bakul14/siemens_kur/second_attempt/strangled.jpg

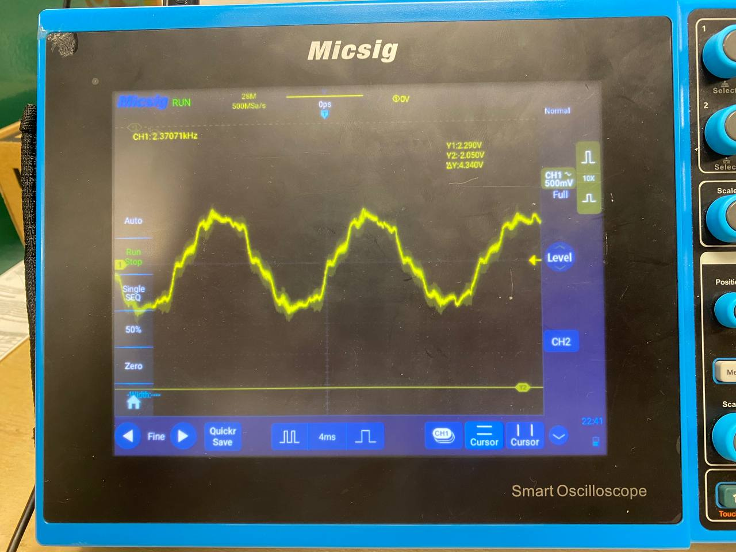
second_attempt/strangled.jpg
