bakul14/siemens_kur/second_attempt/figner_only.jpg

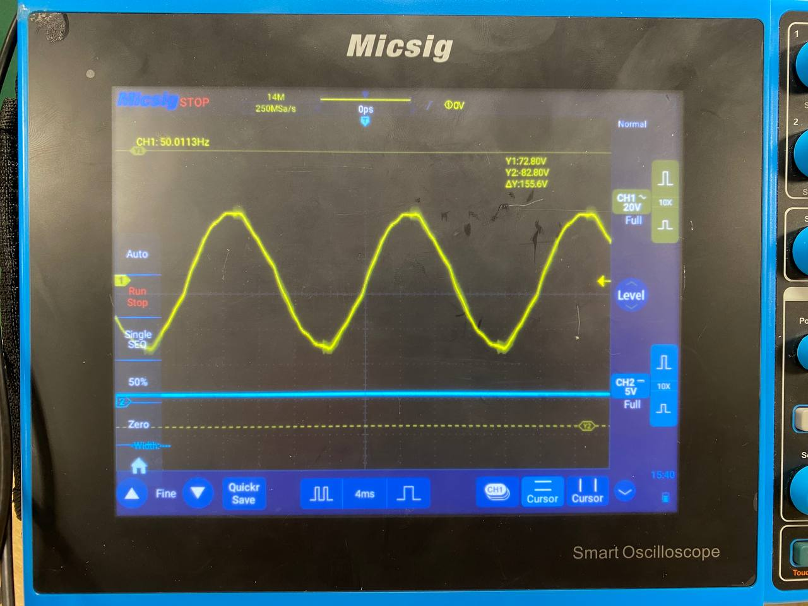
second_attempt/figner_only.jpg
