bakul14/siemens_kur/PDFs/ПЭ_Бакулевский.pdf

Поз.
обозначение

### Наименование

Кол.
Примеч.

Диоды

VD2, VD3 | 15SQ045 (Dongguan YFW, Китай) | 2
VD1 | 1N4002 (Diotec Semiconductor, Германия) | 1

Конденсаторы

С4 | К10-17Б 1000пФ 50В ±5% (Murata Electronics, Япония) | 1
С1 | К10-17Б 220пФ 50В ±5% (Murata Electronics, Япония) | 1
С7 | К73-17 0,68мкФ 250В ±5% | 1

(Кузнецкий завод конденсаторов, Россия)

С6, С8 | К50-35 2200мкФ 35В ±20% (JB Capacitors, Гонконг) | 2
С2, С5 | К50-35 мини 47мкФ 50В ±20% (JB Capacitors, Гонконг) | 2
С3 | К50-35 100мкФ 63В ±20% (JB Capacitors, Гонконг)

Разъёмы

XS1 | Гнездо стерео 3,5мм ST-025 | 1
| (Dragon City Industries, Китай)
XP1 | Клеммник разъёмный 15EDGRC-3.81-03P (Degson, Китай) | 1
XP2 | Клеммник разъёмный 15EDGRC-3.81-02P (Degson, Китай) | 1

Резисторы

R14, R15 | CF-25 0,25Вт 4.7кОм ±5% | 2
R3, R5 | CF-25 0,25Вт 680Ом ±5% | 2
R12, R13 | CF-25 0,25Вт 3кОм ±5% | 2
R11 | CF-25 0,25Вт 15кОм ±5% | 1

# ИУ4.11.03.03.23.05.52.04.001 ПЭ3

Изм | Лист | № докум. | Подп. | Дата
Разраб. | Бакулевский

## Усилитель низкой частоты

Перечень элементов

Лит. | Лист | Листов
Пров. | Семенцов С. Г. | 1 | 2
МГТУ им Н.Э. Баумана
Кафедра ИУ4
Группа ИУ4 – 52Б

Н. контр.
Утв.

Поз. обозначение | Наименование | | Примеч.
R7 | CF-25 0,25Вт 1,2кОм ±5% | 1
R14 | CF-25 0,25Вт 2кОм ±5% | 1
R18 | CF-100 1Вт 10Ом ±5% | 1
R4 | CF-100 1Вт 15кОм ±5% | 2
R6, R17 | SQP 5Вт 0,1Ом ±5% | 2
RP1 | 3296W-1-1-2LF 0,25Вт 1кОм ±20% (Bourns, США) | 1

Кол.

Транзисторы

VT3, VT4, VT6 | BC546B (Diotec Semiconductor, Германия) | 3
VT1, VT2, VT5 | BC556B (Diotec Semiconductor, Германия) | 3
VT7 | IRF540NPBF (Infineon Technologies, Германия) | 1
VT8 | IRF9540NPBF (Infineon Technologies, Германия) | 1

# ИУ4.11.03.03.23.05.52.04.001 ПЭ 3

Лист

2
Изм | Лист | № докум. | Подп. | Дата
