bakul14/siemens_kur/PDFs/ПД2_Бакулевский.pdf

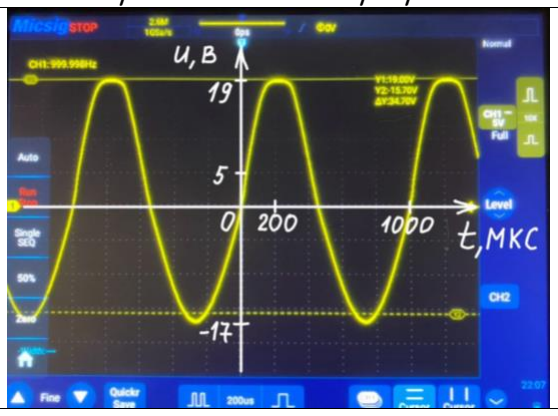
[picture p22: figure]

Максимальная мощность

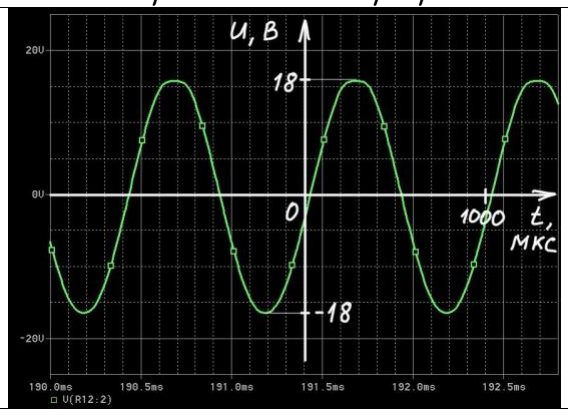
[picture p23: figure]

Теоретический график | Практический график | Вывод
| | Амплитуда входного сигнала: 80мВ; Амплитуда теоретического сигнала: 18В; Амплитуда измеренного сигнала: 19В у верхней полуволны и 17В у нижней полуволны; Сопротивление нагрузки: 3Ом; Частота: 1кГц; 2 (18×0,71) = 54Вт; Мощность: 3 Максимальная мощность усилителя совпадает с расчетной.

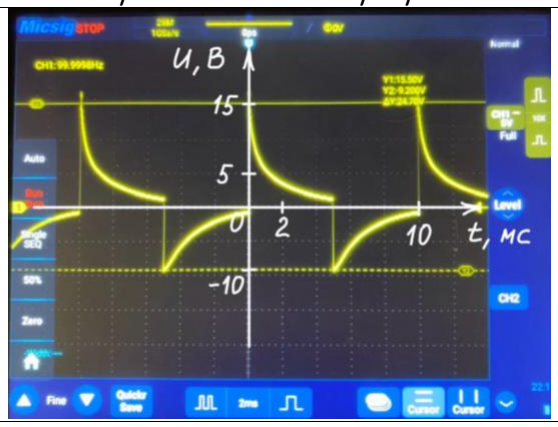
[picture p24: figure]

Переходная характеристика: 100 Гц

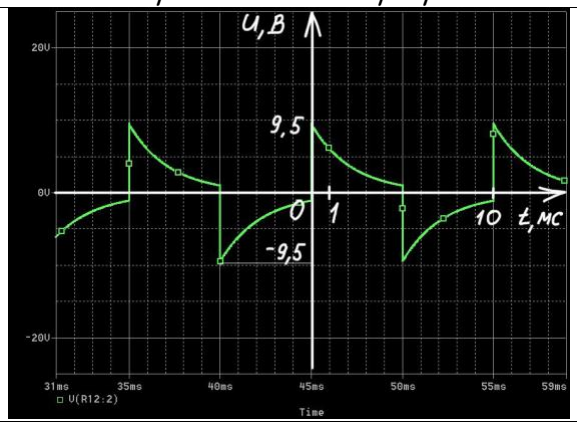
[picture p25: figure]

Теоретический график | Практический график | Вывод
| | Амплитуда входного сигнала: 25мВ; Амплитуда измеренного выходного сигнала выше расчетного;

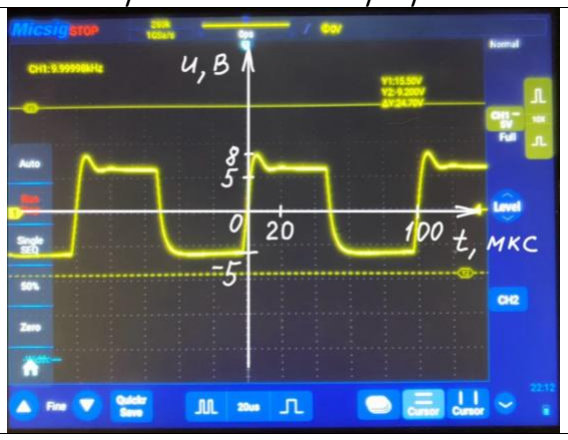
[picture p26: figure]

Переходная характеристика: 10 кГц

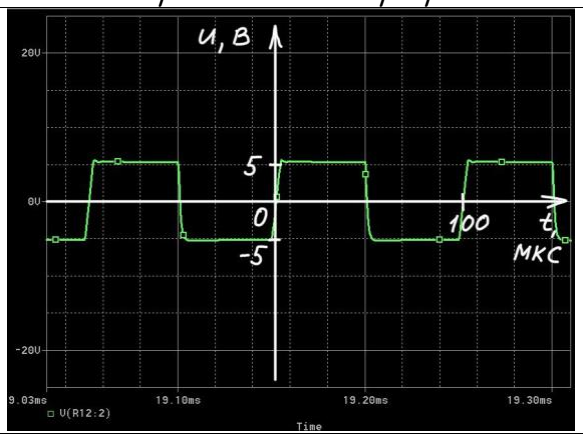
[picture p27: figure]

Теоретический график | Практический график | Вывод
| | Амплитуда входного сигнала: 25мВ; Амплитуда измеренного выходного сигнала совпадает с расчетной; Выброс на фронте измеренного сигнала выше расчетного.

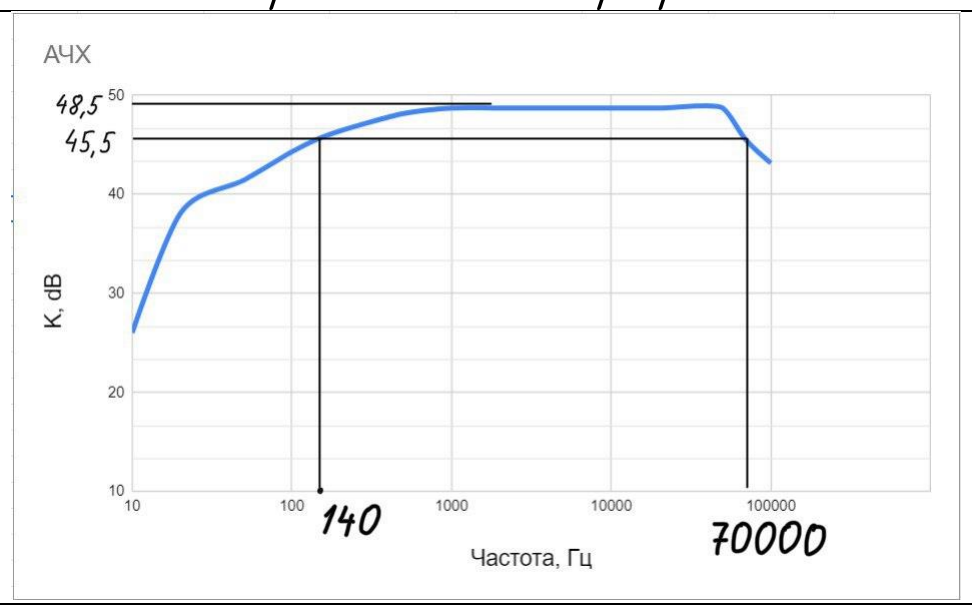
[picture p28: figure]

Амплитудо-частотная характеристика

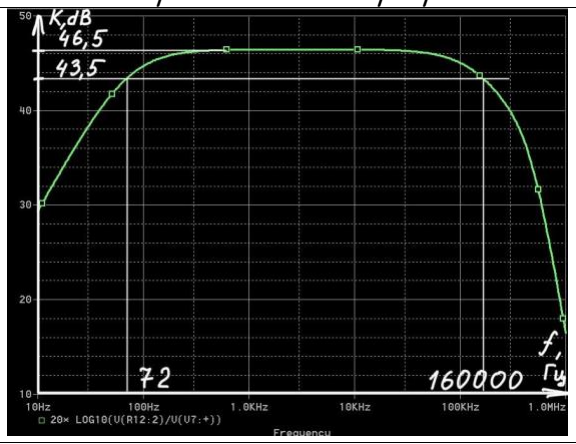
[picture p29: figure]

Теоретический график | Практический график | Вывод
| | Амплитуда входного сигнала: 25мВ; Расчетная полоса пропускания: 72Гц…160кГц; Измеренная полоса пропускания: 140Гц…70кГц.
