bakul14/siemens_kur/second_attempt/new_finger.jpg

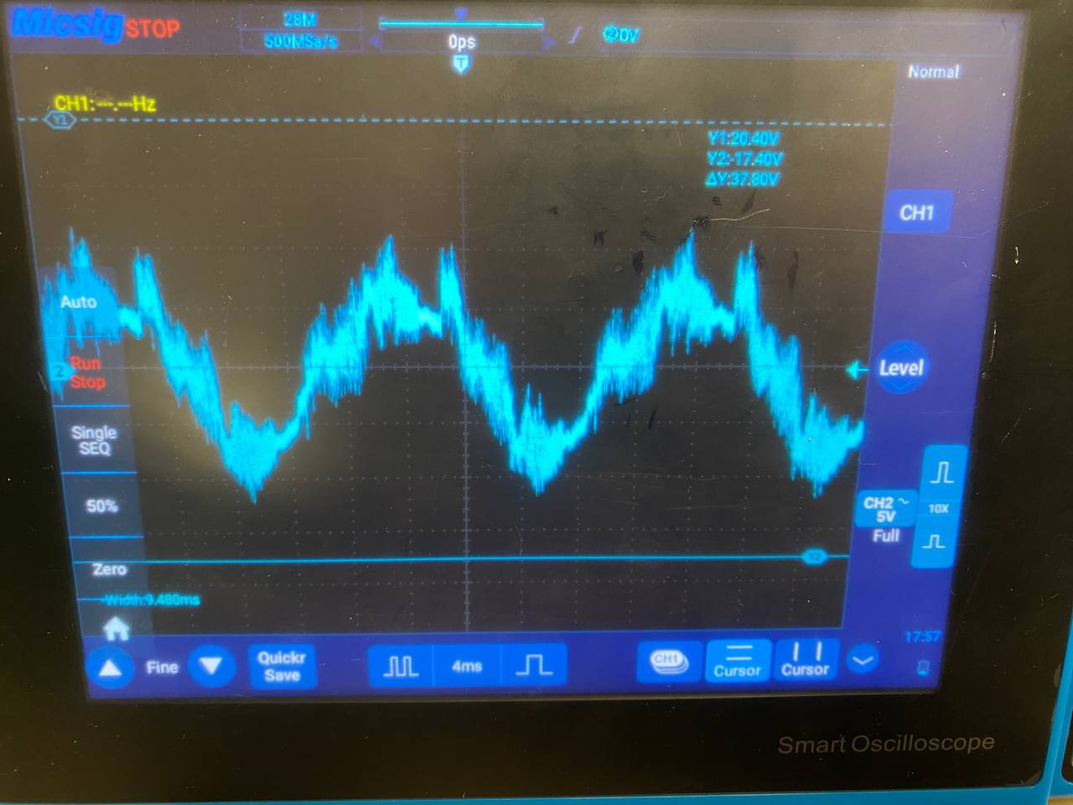
second_attempt/new_finger.jpg
