bakul14/siemens_kur/second_attempt/scheme.png

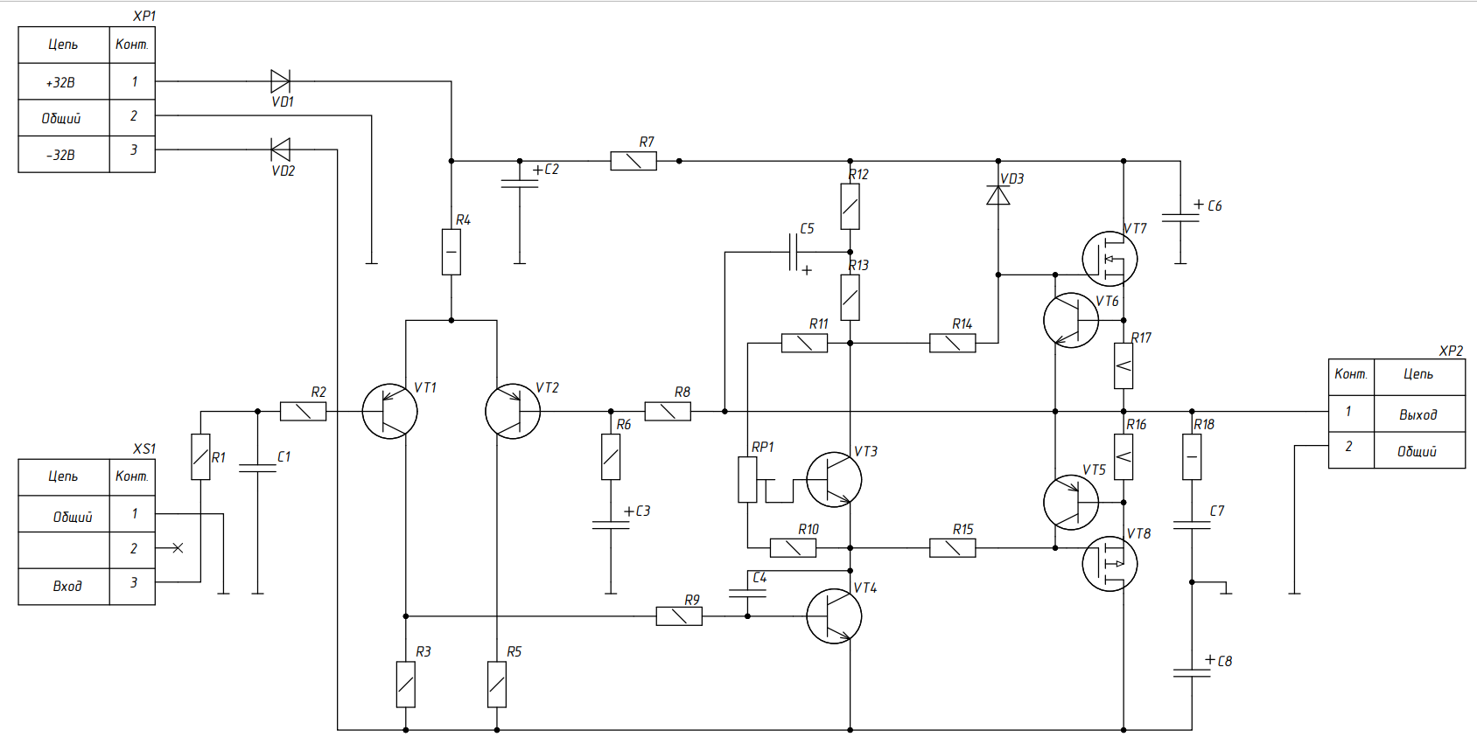
second_attempt/scheme.png
