bakul14/siemens_kur/second_attempt/strangled_with_finger.jpg

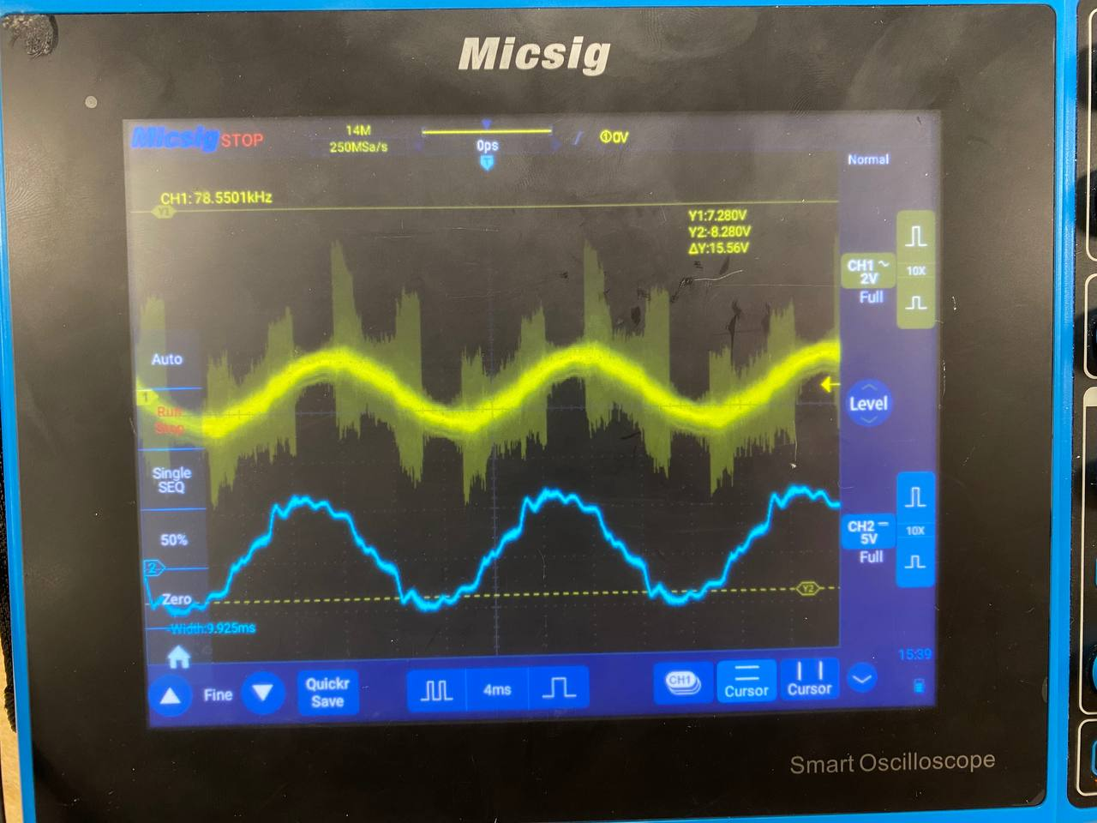
second_attempt/strangled_with_finger.jpg
