bakul14/siemens_kur/src/word/1khz.png

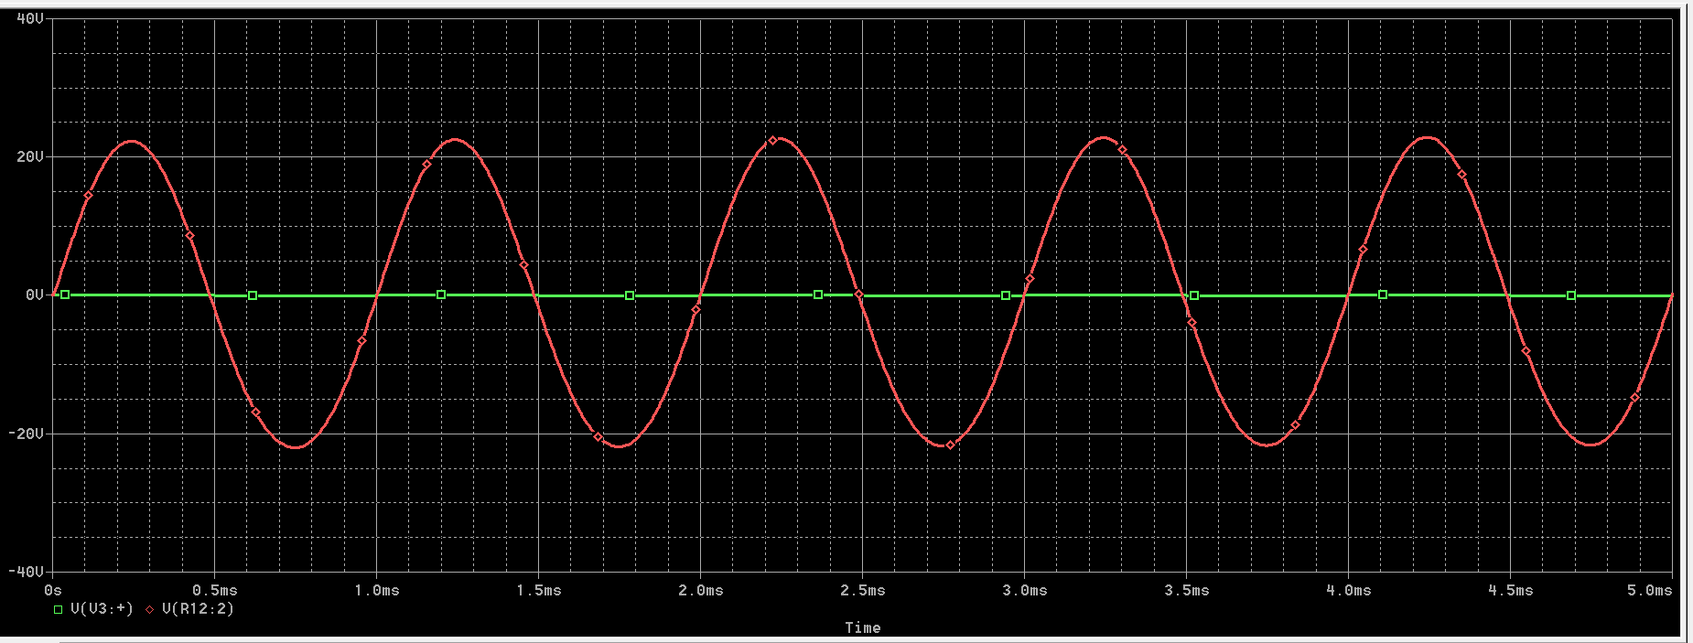
src/word/1khz.png
