bakul14/siemens_kur/src/word/20k.png

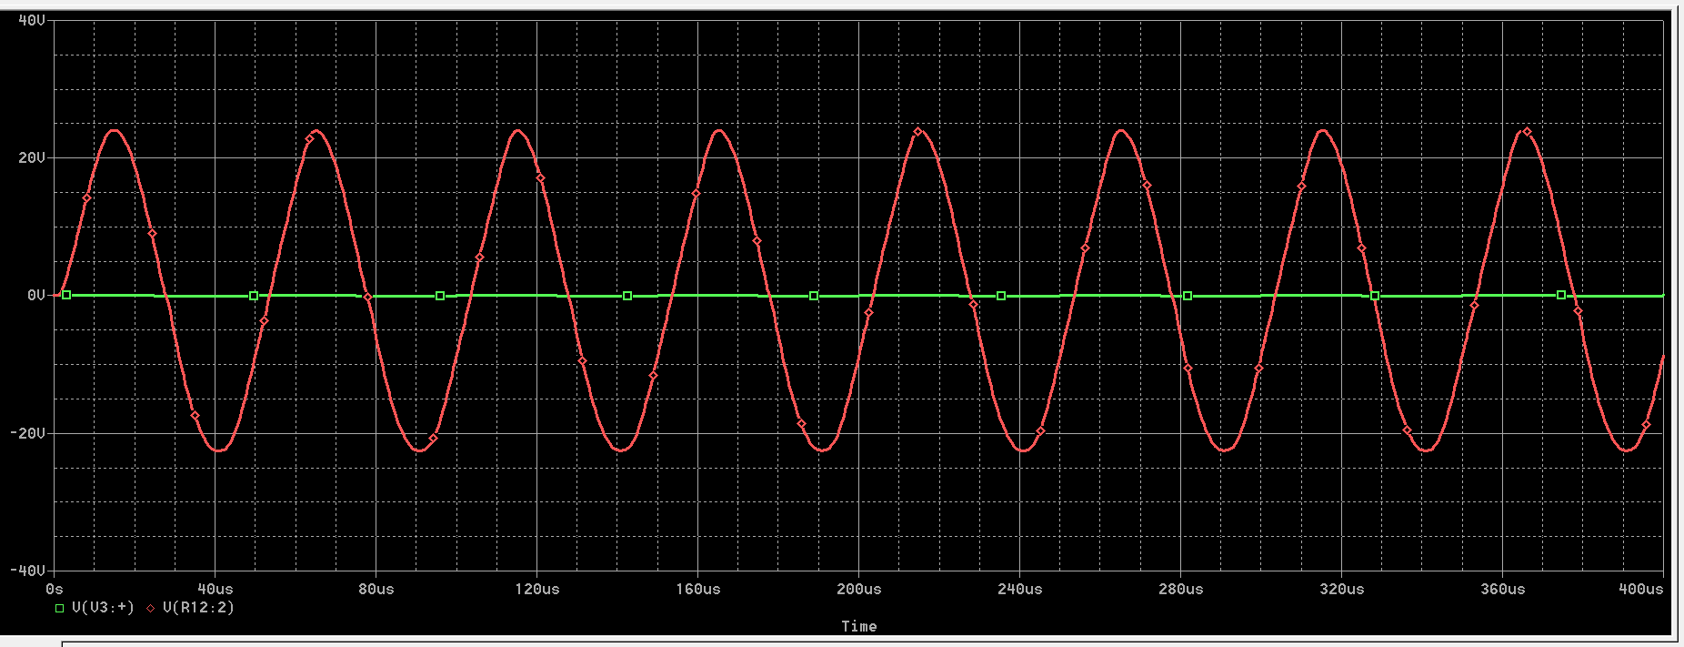
src/word/20k.png
