bakul14/siemens_kur/src/word/max_power.jpg

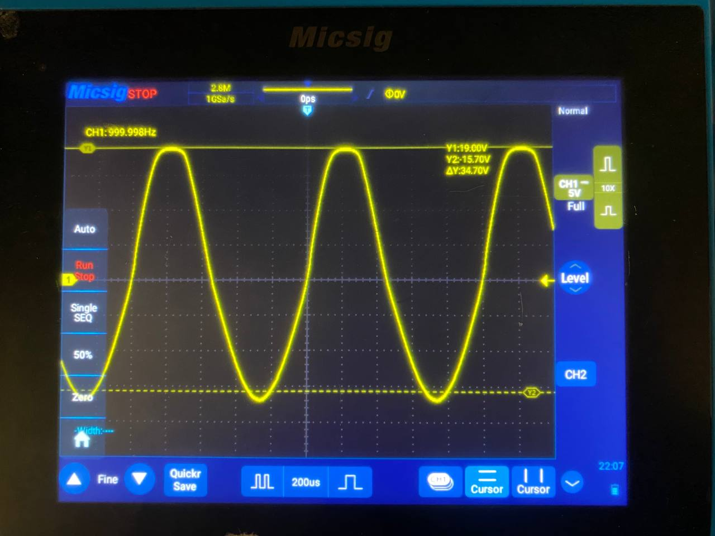
src/word/max_power.jpg
