bakul14/siemens_kur/src/word/pulse.png

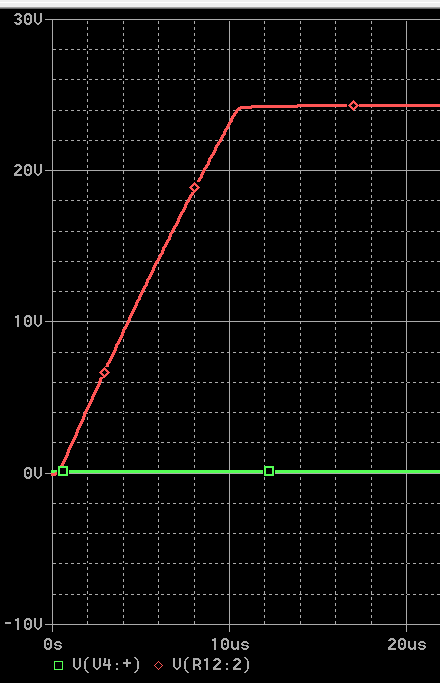
src/word/pulse.png
