bakul14/siemens_kur/src/word/pulse_wide.png

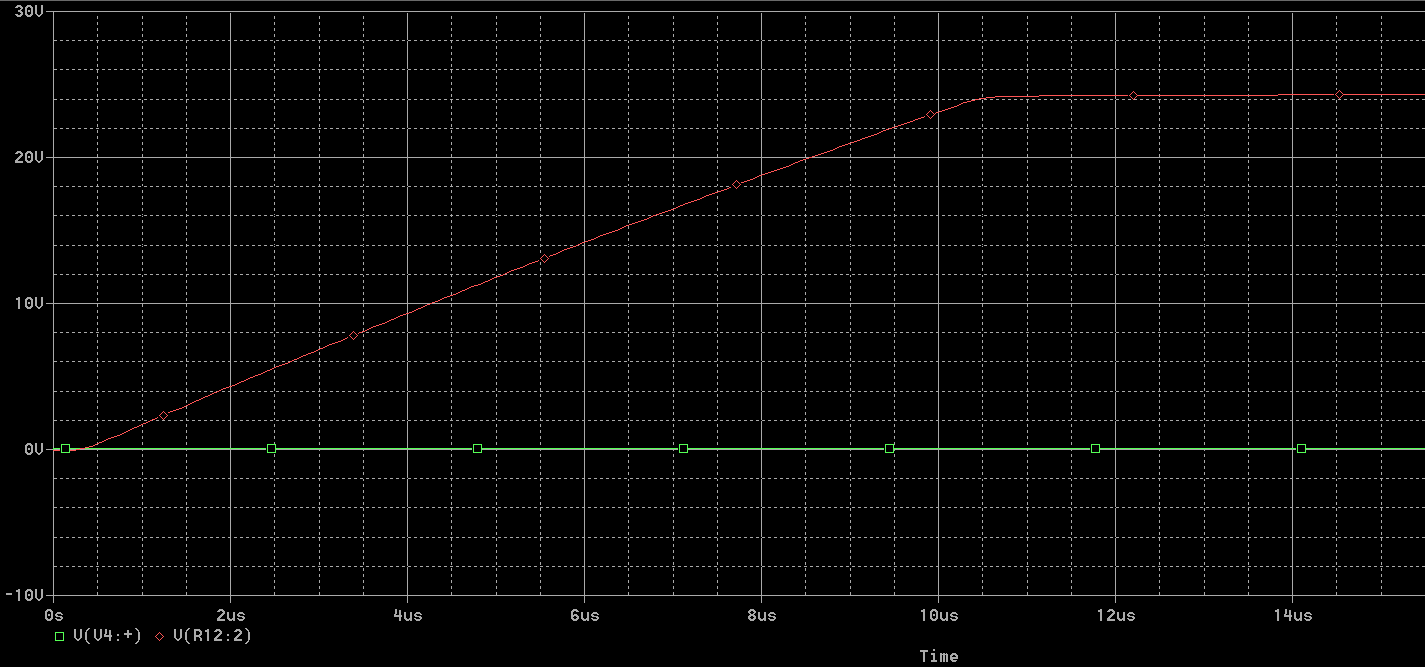
src/word/pulse_wide.png
