bakul14/siemens_kur/src/altium/amplifier60w/PCB1.step

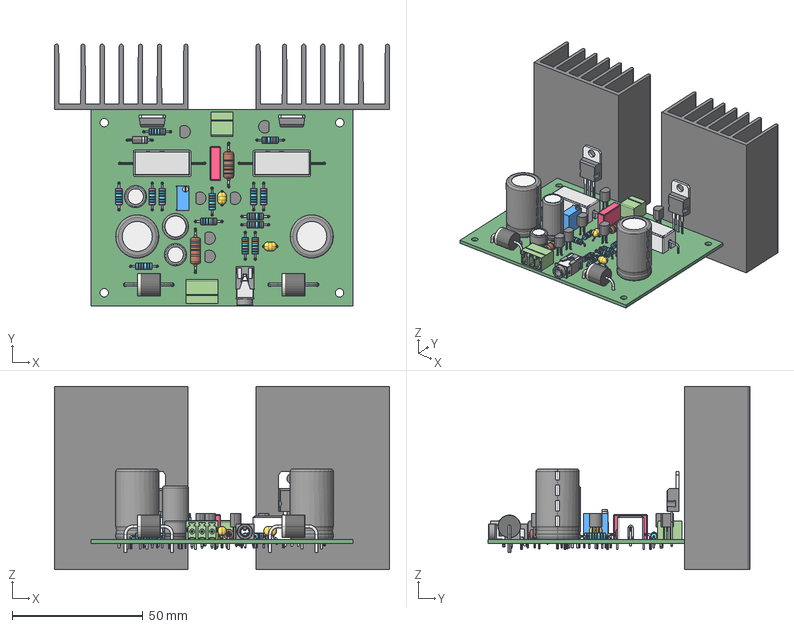
[picture p50: CAD file, 2023-12-01]
src/altium/amplifier60w/PCB1.step
128.0 x 100.0 x 70.0 mm
15EDGRC-3.81-03P-14-00A(H)_RGB5220458
15EDGRC-3.81-02P-14-00A(H)_RGB5220458
Telo_konektora
Kontakt_most
Kontakt_1
Kontakt_2
User_Library-TO-220-4_Case_TO-220_____________ x 2
User_Library-TO-220-4_Rad_Case_TO-220_____________ x 2
User_Library-TO-92B x 6
R6,_axial x 2
DO_41_375mil001
DO_41_375mil
DO_41_375mil003
RESAR3250W80L2200T1000H900_5W x 2
TRIM_BOURNS_3296Y
CAPR1000-400X1300X950
CAPRR508-350X500X500 x 2
CAPPR500-1000X2050
CAPPR350-800X700 x 2
radiator_RGB4408131 x 2
