bakul14/siemens_kur/(list of files, cad)

Other CAD files:
src/inventor/assembling2.dwg
src/inventor/assembling.dwg
src/inventor/e1.dwg
src/altium/amplifier60w/Sheet1.dwg
src/inventor/OldVersions/assembling2.0018.dwg
src/inventor/OldVersions/assembling2.dwg
src/inventor/OldVersions/assembling.0017.dwg
src/inventor/OldVersions/e1.0007.dwg
src/altium/amplifier60w/PCB1/15EDGRC-3.81-02P-14-00A(H)_RGB5220458.ipt
src/altium/amplifier60w/PCB1/15EDGRC-3.81-03P-14-00A(H)_RGB5220458.ipt
src/altium/amplifier60w/PCB1/Audio_Jack_3.5_mm__Cliff_FC68125.iam
src/altium/amplifier60w/PCB1/Board.iam
src/altium/amplifier60w/PCB1/C1.iam
src/altium/amplifier60w/PCB1/C2.iam
src/altium/amplifier60w/PCB1/C3.iam
src/altium/amplifier60w/PCB1/C4.iam
src/altium/amplifier60w/PCB1/C5.iam
src/altium/amplifier60w/PCB1/C6.iam
src/altium/amplifier60w/PCB1/C7.iam
src/altium/amplifier60w/PCB1/C8.iam
src/altium/amplifier60w/PCB1/CAPPR350-800X700.ipt
src/altium/amplifier60w/PCB1/CAPPR500-1000X2050.ipt
src/altium/amplifier60w/PCB1/CAPPR750-1650X2700.iam
src/altium/amplifier60w/PCB1/CAPR1000-400X1300X950.ipt
src/altium/amplifier60w/PCB1/CAPRR508-350X500X500.ipt
src/altium/amplifier60w/PCB1/DO_41_375mil.ipt
src/altium/amplifier60w/PCB1/DO_41_375mil001.ipt
src/altium/amplifier60w/PCB1/DO_41_375mil003.ipt
src/altium/amplifier60w/PCB1/Fillet.ipt
src/altium/amplifier60w/PCB1/Fillet001.ipt
src/altium/amplifier60w/PCB1/Free-Models.iam
src/altium/amplifier60w/PCB1/Kontakt_1.ipt
src/altium/amplifier60w/PCB1/Kontakt_2.ipt
src/altium/amplifier60w/PCB1/Kontakt_most.ipt
src/altium/amplifier60w/PCB1/OldVersions/15EDGRC-3.81-02P-14-00A(H)_RGB5220458.0001.ipt
src/altium/amplifier60w/PCB1/OldVersions/15EDGRC-3.81-03P-14-00A(H)_RGB5220458.0001.ipt
src/altium/amplifier60w/PCB1/OldVersions/Audio_Jack_3.5_mm__Cliff_FC68125.0001.iam
src/altium/amplifier60w/PCB1/OldVersions/Board.0001.iam
src/altium/amplifier60w/PCB1/OldVersions/C1.0001.iam
src/altium/amplifier60w/PCB1/OldVersions/C2.0001.iam
src/altium/amplifier60w/PCB1/OldVersions/C3.0001.iam
src/altium/amplifier60w/PCB1/OldVersions/C4.0001.iam
src/altium/amplifier60w/PCB1/OldVersions/C5.0001.iam
src/altium/amplifier60w/PCB1/OldVersions/C6.0001.iam
src/altium/amplifier60w/PCB1/OldVersions/C7.0001.iam
src/altium/amplifier60w/PCB1/OldVersions/CAPPR350-800X700.0001.ipt
src/altium/amplifier60w/PCB1/OldVersions/CAPPR500-1000X2050.0001.ipt
src/altium/amplifier60w/PCB1/OldVersions/CAPPR750-1650X2700.0001.iam
src/altium/amplifier60w/PCB1/OldVersions/CAPR1000-400X1300X950.0001.ipt
src/altium/amplifier60w/PCB1/OldVersions/CAPRR508-350X500X500.0001.ipt
src/altium/amplifier60w/PCB1/OldVersions/DO_41_375mil.0001.ipt
src/altium/amplifier60w/PCB1/OldVersions/DO_41_375mil001.0001.ipt
src/altium/amplifier60w/PCB1/OldVersions/DO_41_375mil003.0001.ipt
src/altium/amplifier60w/PCB1/OldVersions/Fillet.0001.ipt
src/altium/amplifier60w/PCB1/OldVersions/Fillet001.0001.ipt
src/altium/amplifier60w/PCB1/OldVersions/Free-Models.0001.iam
src/altium/amplifier60w/PCB1/OldVersions/Kontakt_1.0001.ipt
src/altium/amplifier60w/PCB1/OldVersions/Kontakt_2.0001.ipt
src/altium/amplifier60w/PCB1/OldVersions/Kontakt_most.0001.ipt
src/altium/amplifier60w/PCB1/OldVersions/PCB1.0001.iam
src/altium/amplifier60w/PCB1/OldVersions/R1.0001.iam
src/altium/amplifier60w/PCB1/OldVersions/R10.0001.iam
src/altium/amplifier60w/PCB1/OldVersions/R11.0001.iam
src/altium/amplifier60w/PCB1/OldVersions/R12.0001.iam
src/altium/amplifier60w/PCB1/OldVersions/R13.0001.iam
src/altium/amplifier60w/PCB1/OldVersions/R14.0001.iam
src/altium/amplifier60w/PCB1/OldVersions/R15.0001.iam
src/altium/amplifier60w/PCB1/OldVersions/R16.0001.iam
src/altium/amplifier60w/PCB1/OldVersions/R17.0001.iam
src/altium/amplifier60w/PCB1/OldVersions/R18.0001.iam
src/altium/amplifier60w/PCB1/OldVersions/R2.0001.iam
src/altium/amplifier60w/PCB1/OldVersions/R3.0001.iam
src/altium/amplifier60w/PCB1/OldVersions/R4.0001.iam
src/altium/amplifier60w/PCB1/OldVersions/R5.0001.iam
src/altium/amplifier60w/PCB1/OldVersions/R6,_axial.0001.ipt
src/altium/amplifier60w/PCB1/OldVersions/R6.0001.iam
src/altium/amplifier60w/PCB1/OldVersions/R7.0001.iam
src/altium/amplifier60w/PCB1/OldVersions/R8.0001.iam
src/altium/amplifier60w/PCB1/OldVersions/R9.0001.iam
src/altium/amplifier60w/PCB1/OldVersions/RES1016-630X250.0001.iam
src/altium/amplifier60w/PCB1/OldVersions/RES1651-1000X390.0001.iam
src/altium/amplifier60w/PCB1/OldVersions/RESAR3250W80L2200T1000H900_5W.0001.ipt
src/altium/amplifier60w/PCB1/OldVersions/RP1.0001.iam
src/altium/amplifier60w/PCB1/OldVersions/TRIM_BOURNS_3296Y.0001.ipt
src/altium/amplifier60w/PCB1/OldVersions/Telo_konektora.0001.ipt
src/altium/amplifier60w/PCB1/OldVersions/User_Library-DO-41_375mil.0001.iam
src/altium/amplifier60w/PCB1/OldVersions/User_Library-TO-220-4.0001.iam
src/altium/amplifier60w/PCB1/OldVersions/User_Library-TO-220-4_Case_TO-220_____________.0001.ipt
src/altium/amplifier60w/PCB1/OldVersions/User_Library-TO-220-4_Rad_Case_TO-220_____________.0001.ipt
src/altium/amplifier60w/PCB1/OldVersions/User_Library-TO-92B.0001.ipt
src/altium/amplifier60w/PCB1/OldVersions/VD1.0001.iam
src/altium/amplifier60w/PCB1/OldVersions/VD2.0001.iam
src/altium/amplifier60w/PCB1/OldVersions/VD3.0001.iam
src/altium/amplifier60w/PCB1/OldVersions/VT1.0001.iam
src/altium/amplifier60w/PCB1/OldVersions/VT2.0001.iam
src/altium/amplifier60w/PCB1/OldVersions/VT3.0001.iam
src/altium/amplifier60w/PCB1/OldVersions/VT4.0001.iam
src/altium/amplifier60w/PCB1/OldVersions/VT5.0001.iam
src/altium/amplifier60w/PCB1/OldVersions/VT6.0001.iam
src/altium/amplifier60w/PCB1/OldVersions/VT7.0001.iam
src/altium/amplifier60w/PCB1/OldVersions/VT8.0001.iam
src/altium/amplifier60w/PCB1/OldVersions/XP1.0001.iam
src/altium/amplifier60w/PCB1/OldVersions/XP2.0001.iam
src/altium/amplifier60w/PCB1/OldVersions/XS1.0001.iam
src/altium/amplifier60w/PCB1/OldVersions/radiator_RGB4408131.0001.ipt
src/altium/amplifier60w/PCB1/Open CASCADE STEP translator 6.8 1.1.1.ipt
src/altium/amplifier60w/PCB1/Open CASCADE STEP translator 6.8 1.16.1.1.ipt
src/altium/amplifier60w/PCB1/Open CASCADE STEP translator 6.8 1.16.1.2.ipt
src/altium/amplifier60w/PCB1/Open CASCADE STEP translator 6.8 1.21.1.1.ipt
src/altium/amplifier60w/PCB1/Open CASCADE STEP translator 6.8 1.21.1.2.ipt
src/altium/amplifier60w/PCB1/Open CASCADE STEP translator 6.8 1.36.1.1.ipt
src/altium/amplifier60w/PCB1/Open CASCADE STEP translator 6.8 1.36.1.2.ipt
src/altium/amplifier60w/PCB1/Open CASCADE STEP translator 6.8 2.1.1.ipt
src/altium/amplifier60w/PCB1/Open CASCADE STEP translator 6.8 2.16.1.1.ipt
src/altium/amplifier60w/PCB1/Open CASCADE STEP translator 6.8 2.16.1.2.ipt
src/altium/amplifier60w/PCB1/Open CASCADE STEP translator 6.8 2.21.1.1.ipt
src/altium/amplifier60w/PCB1/Open CASCADE STEP translator 6.8 2.21.1.2.ipt
src/altium/amplifier60w/PCB1/Open CASCADE STEP translator 6.8 2.36.1.1.ipt
src/altium/amplifier60w/PCB1/Open CASCADE STEP translator 6.8 2.36.1.2.ipt
src/altium/amplifier60w/PCB1/PCB1.iam
src/altium/amplifier60w/PCB1/R1.iam
src/altium/amplifier60w/PCB1/R10.iam
src/altium/amplifier60w/PCB1/R11.iam
src/altium/amplifier60w/PCB1/R12.iam
src/altium/amplifier60w/PCB1/R13.iam
src/altium/amplifier60w/PCB1/R14.iam
src/altium/amplifier60w/PCB1/R15.iam
src/altium/amplifier60w/PCB1/R16.iam
src/altium/amplifier60w/PCB1/R17.iam
src/altium/amplifier60w/PCB1/R18.iam
src/altium/amplifier60w/PCB1/R2.iam
src/altium/amplifier60w/PCB1/R3.iam
src/altium/amplifier60w/PCB1/R4.iam
src/altium/amplifier60w/PCB1/R5.iam
src/altium/amplifier60w/PCB1/R6,_axial.ipt
src/altium/amplifier60w/PCB1/R6.iam
src/altium/amplifier60w/PCB1/R7.iam
src/altium/amplifier60w/PCB1/R8.iam
src/altium/amplifier60w/PCB1/R9.iam
src/altium/amplifier60w/PCB1/RES1016-630X250.iam
src/altium/amplifier60w/PCB1/RES1651-1000X390.iam
src/altium/amplifier60w/PCB1/RESAR3250W80L2200T1000H900_5W.ipt
src/altium/amplifier60w/PCB1/RP1.iam
src/altium/amplifier60w/PCB1/TRIM_BOURNS_3296Y.ipt
src/altium/amplifier60w/PCB1/Telo_konektora.ipt
src/altium/amplifier60w/PCB1/User_Library-DO-41_375mil.iam
src/altium/amplifier60w/PCB1/User_Library-TO-220-4.iam
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
