bakul14/siemens_kur/src/inventor/assembling2.pdf

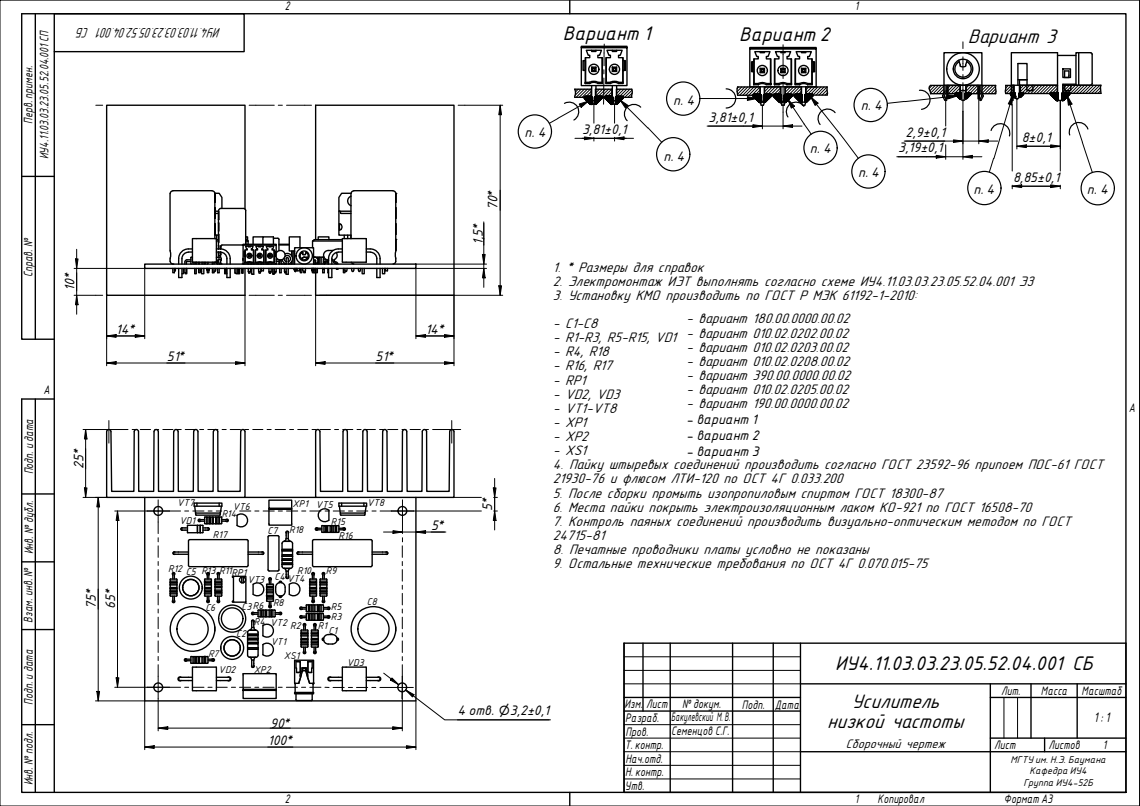
[picture p51: page 1]

1. * Размеры для справок
2. Электромонтаж ИЭТ выполнять согласно схеме ИУ4.11.03.03.23.05.52.04.001 ЭЗ
3. Установку КМО производить по ГОСТ Р МЭК 61192-1-2010:

4. Пайку штыревых соединений производить согласно ГОСТ 23592-96 припоем ПОС-61 ГОСТ
21930-76 и флюсом ЛТИ-120 по ОСТ 4Г 0.033.200
5. После сборки промыть изопропиловым спиртом ГОСТ 18300-87
6. Места пайки покрыть электроизоляционным лаком КО-921 по ГОСТ 16508-70
7. Контроль паяных соединений производить визуально-оптическим методом по ГОСТ
8. Печатные проводники платы условно не показаны
9. Остальные технические требования по ОСТ 4Г 0.070.015-75

Усилитель низкой частоты Сборочный чертеж | Лит. | Масса | Масштаб

Изм. | Лист | № докум. | Подп. | Дата | | | | | 1 : 1
Разраб. | | Бакулевский М. В.
Пров. | | Семенцов С.Г.
Т. контр. | | | | | Лист | Листов 1
Нач.отд. | | | | | МГТУ им. Н.Э. Баумана Кафедра ИУ4 Группа ИУ4-52Б
Н. контр.
Утв.
