bakul14/siemens_kur/PDFs/Э3_Бакулевский.pdf

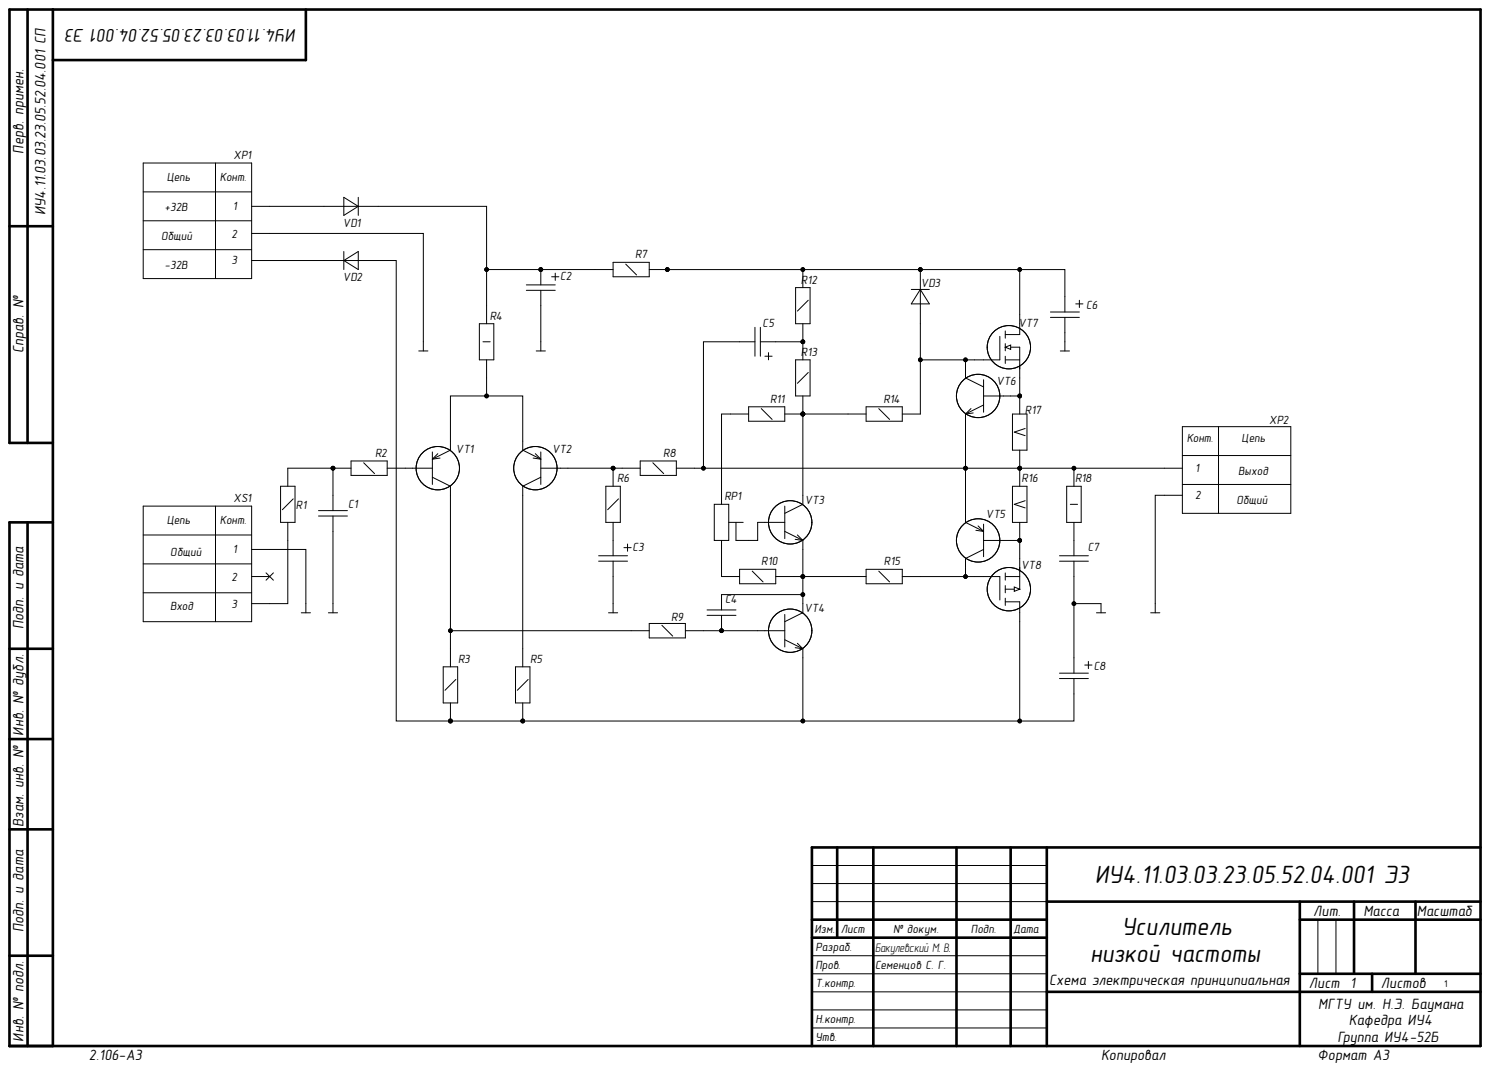
[picture p52: page 1]

Инв. № подл. Инв. № дубл. Подп. и дата Взам. инв. № Подп. и дата Перв. примен. Справ. №

Цеп ь | Кон т .

Кон т . | Цеп ь

12 | Выхо д

Общий

Усилитель низкой частоты Схем а электрическая принципиальная | Лит . | Масса | Масштаб

Изм . | Лис т | № докум . | Под п . | Дат а
Разраб. | | Бакулевский М. В.
Про в. | | Семенцов С . Г .
Т . кон т р . | | | | | Лист 1 | Листов 1

МГТ У им. Н . Э. Баумана Кафедра И У 4 Группа И У 4-52 Б

Н . кон т р .
Ут в.
