bakul14/siemens_kur/PDFs/Job2.PDF

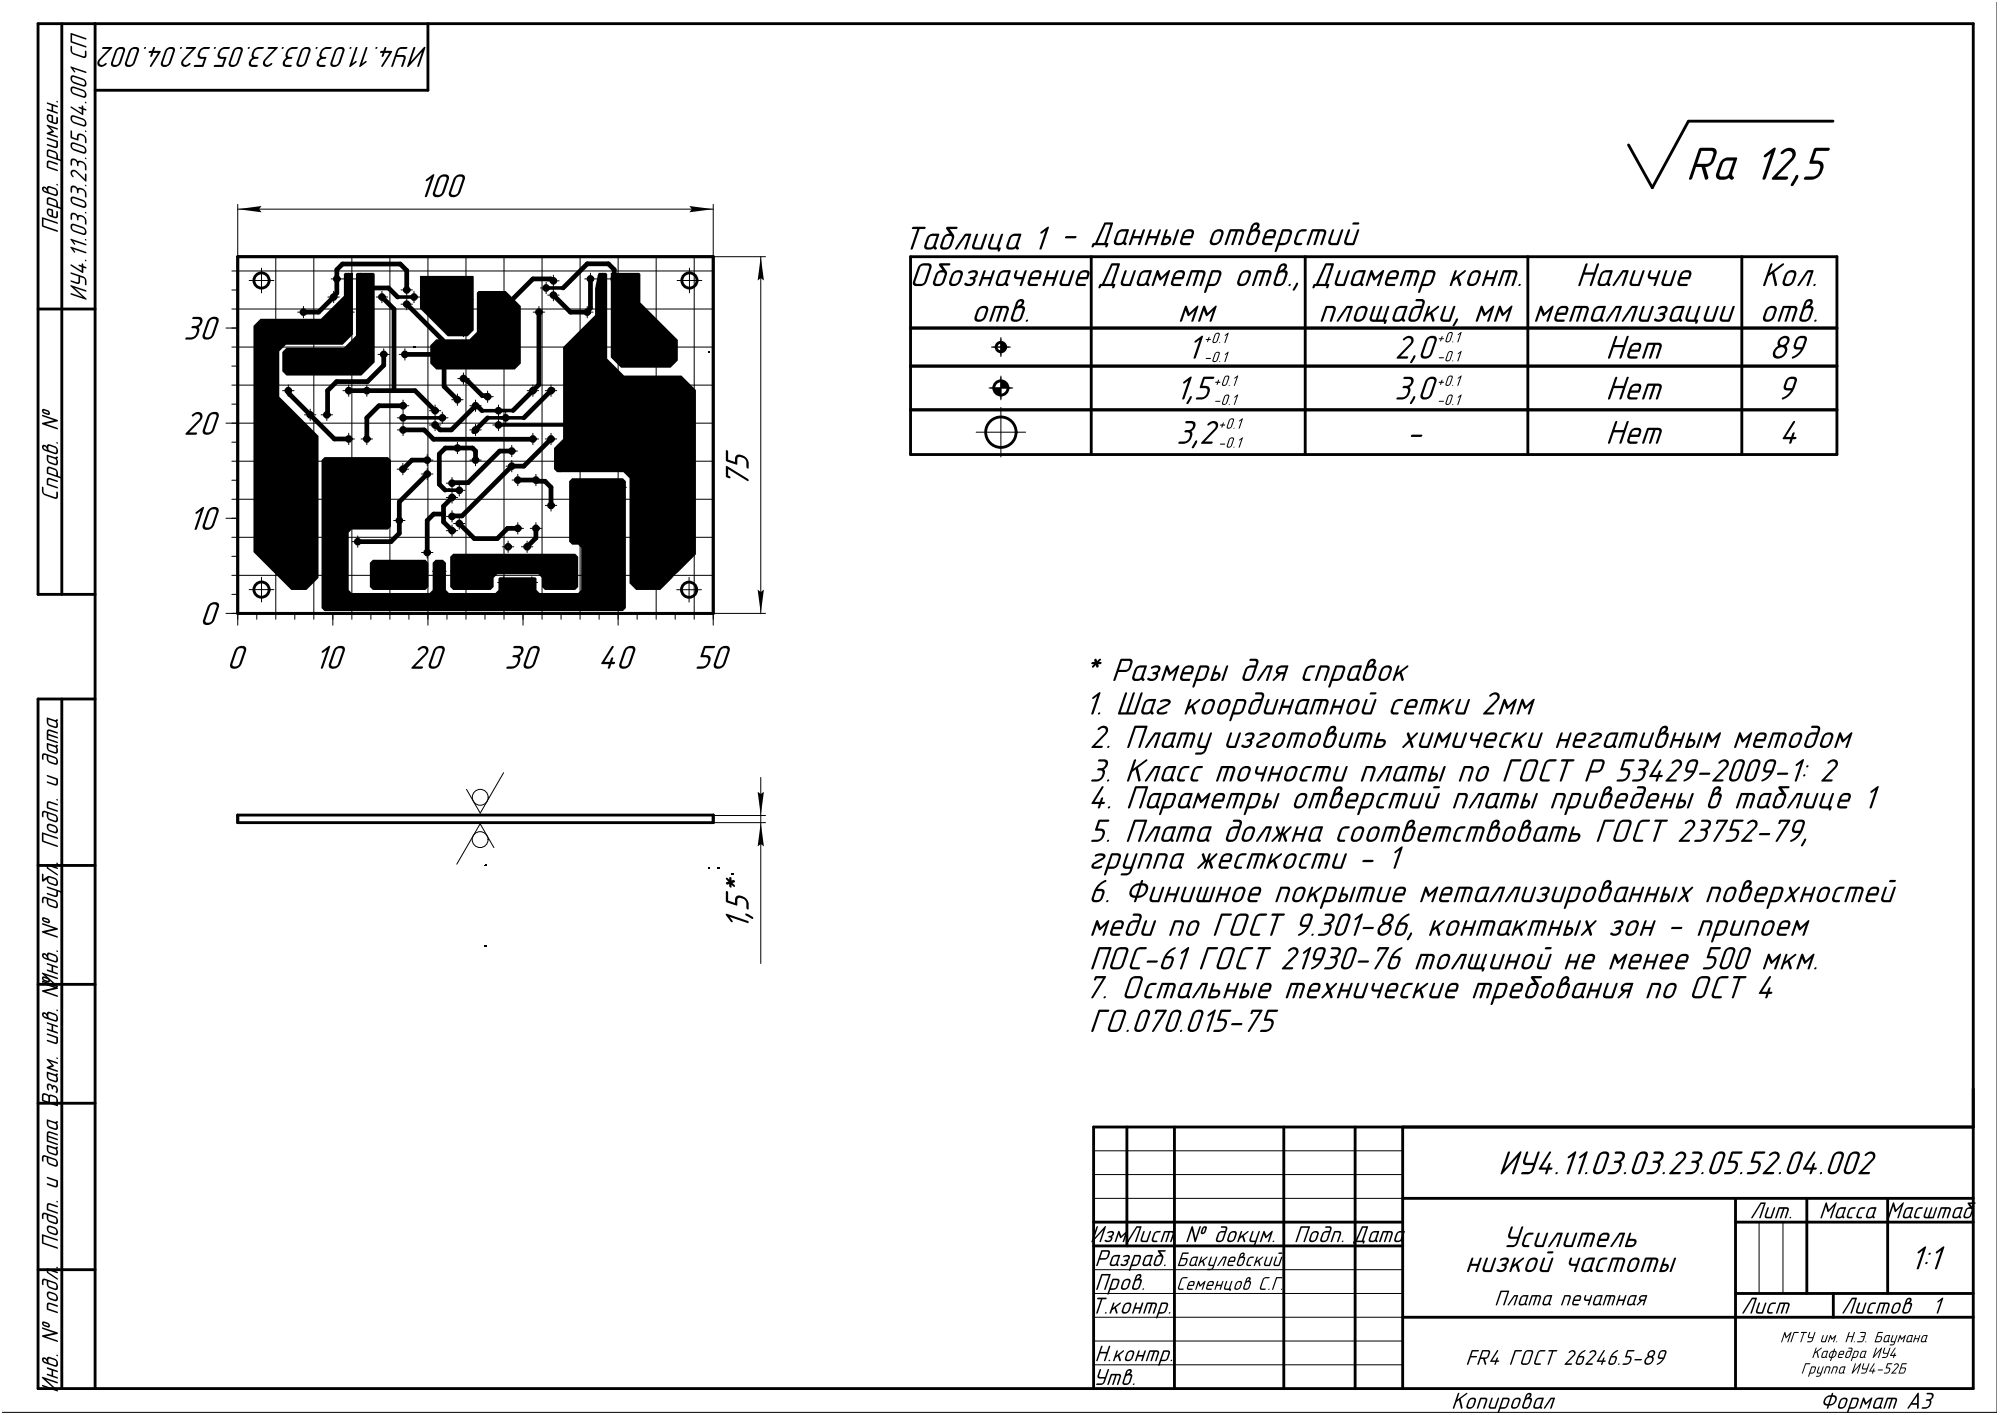
[picture p53: page 1]
