bakul14/siemens_kur/PDFs/Э1_Бакулевский.pdf

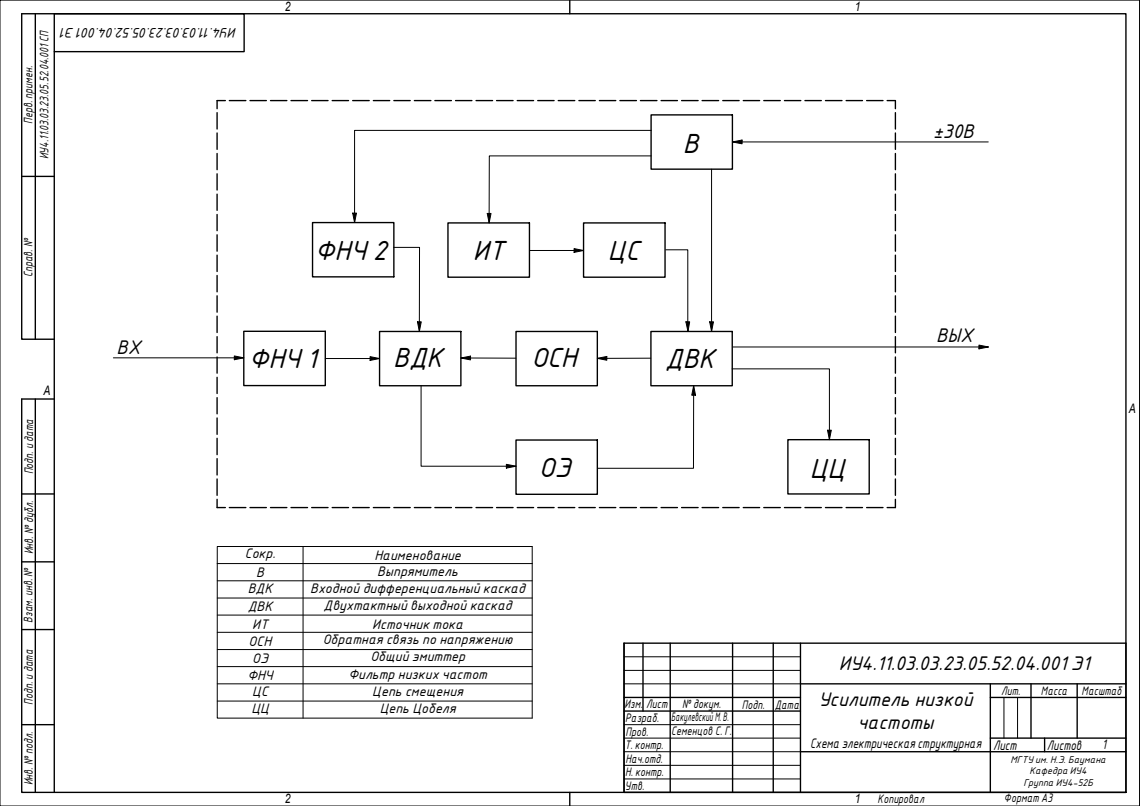
[picture p54: page 1]
ФНЧ 1; ВДК; ОСН; ФНЧ 2; Т. контр.; Усилитель низкой; Схема электрическая структурная; Формат A3; Цепь смещения; Инв. №; л. Под; бл. Под; Перв. п

Сокр. | Наименование
В | Выпрямитель
ВДК | Входной дифференциальный каскад
ДВК | Двухтактный выходной каскад
ИТ | Источник тока
ОСН | Обратная связь по напряжению
ОЭ | Общий эмиттер
ФНЧ | Фильтр низких частот

Изм. | Лист | № докум. | Подп. | Дата
Разраб. | | Бакулевский М. В.
Пров. | | Семенцов С. Г.

ЦЦ | Цепь Цобеля

Нач.отд. | МГТУ им. Н.Э. Баумана Кафедра ИУ4 Группа ИУ4-52Б
Н. контр.
Утв.
