bakul14/siemens_kur/PDFs/ПД1_Бакулевский.pdf

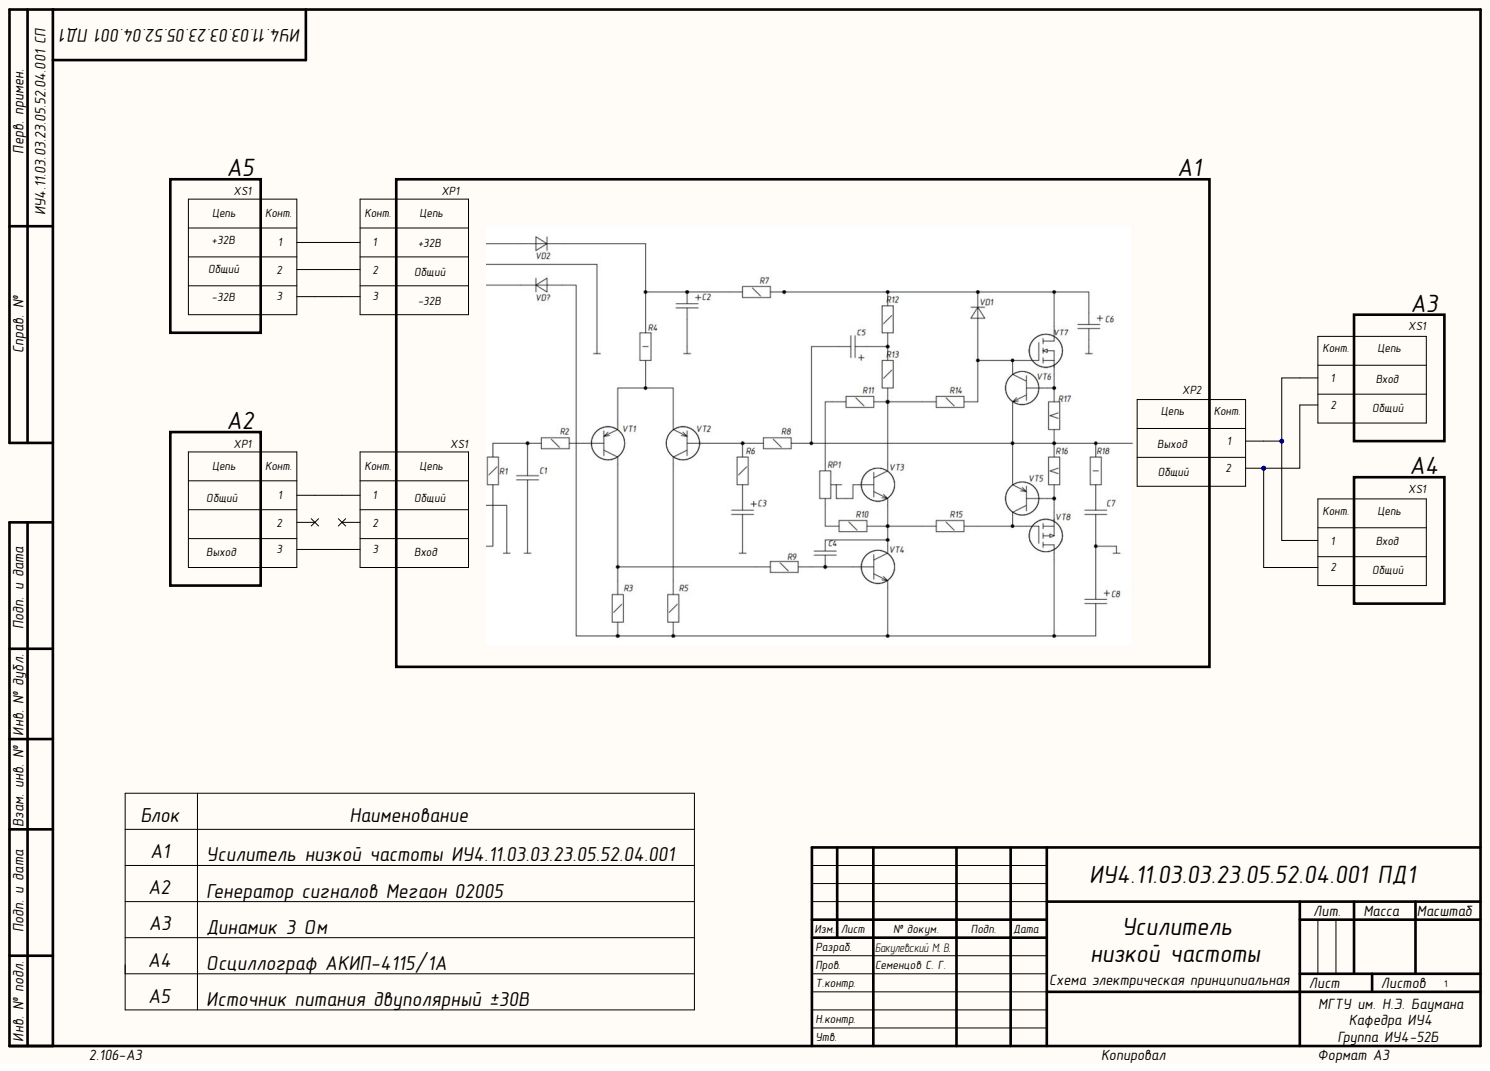
[picture p55: page 1]

Инв. № подл. Инв. № дубл. Подп. и дата Взам. инв. № Подп. и дата Перв. примен. Справ. №

1 | Вход

2 | Общий

Цепь | Конт.

Конт. | Цепь

Блок | Наименование

А1 | Усилитель низкой частоты ИУ4.11.03.03.23.05.52.04.001

А2 | Генератор сигналов Мегаон 02005

МГТУ им. Н.Э. Баумана Кафедра ИУ4 Группа ИУ4-52Б

Н.контр.
Утв.
