bakul14/siemens_kur/PDFs/ПП_Бакулевский.pdf

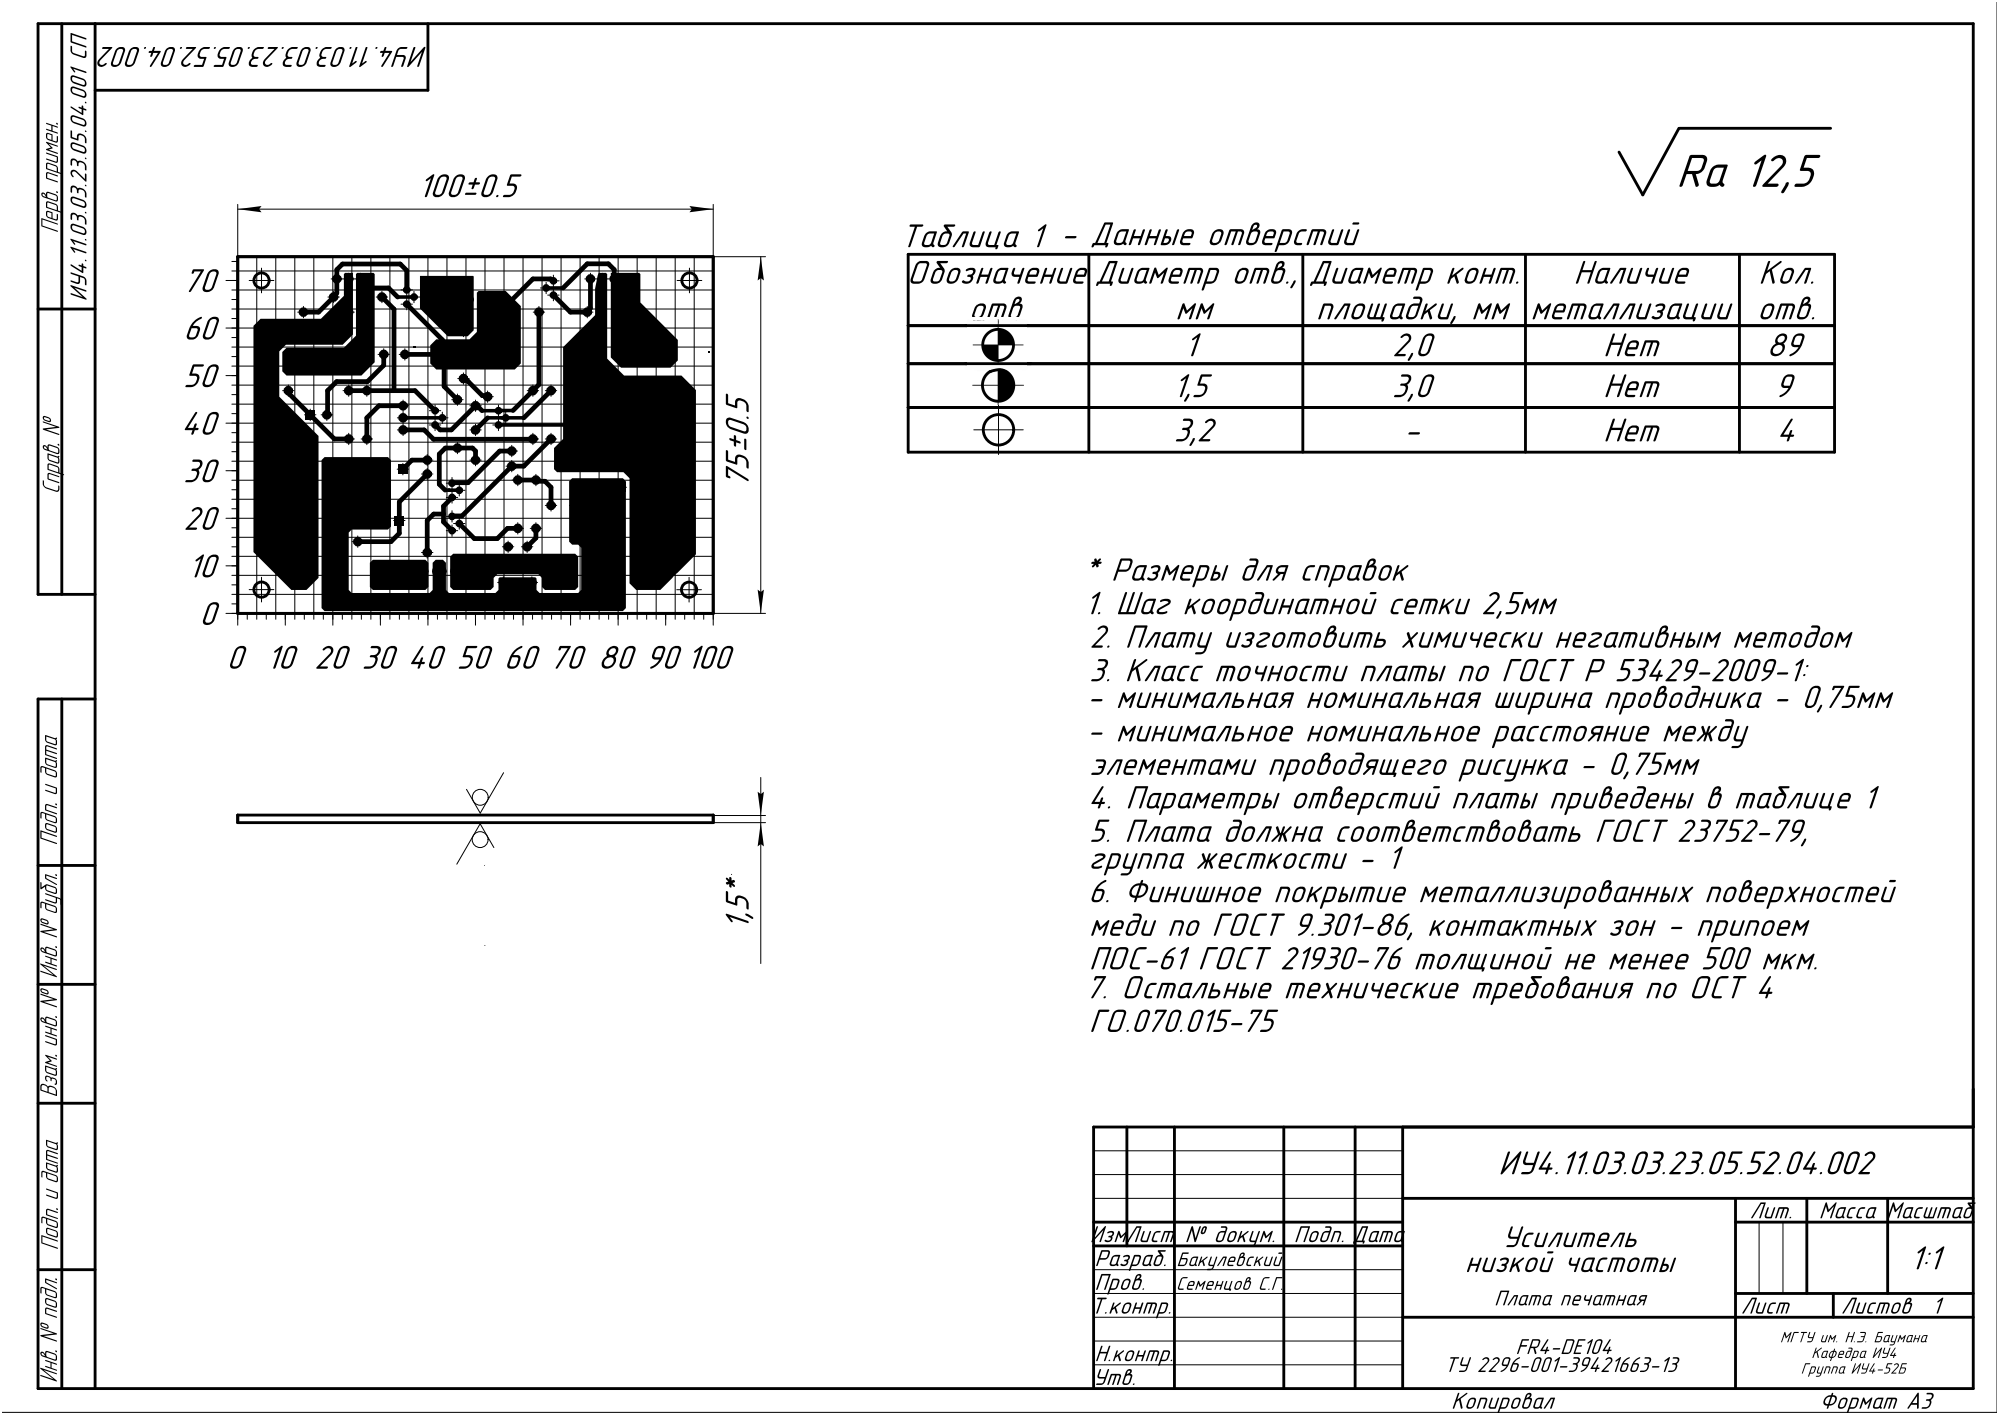
[picture p56: page 1]
COZBOAS196893188; COZBOAS196894921; COZBOAS751997893; atccer
