bakul14/siemens_kur/src/inventor/e1.pdf

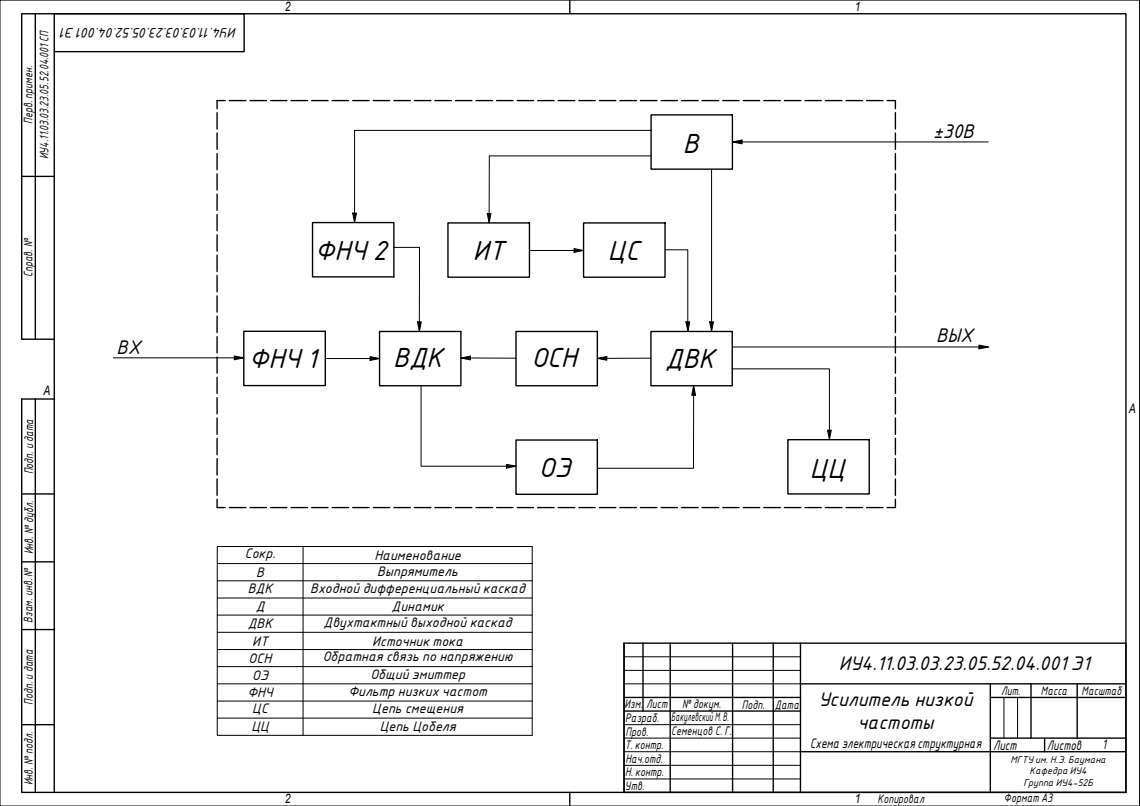
[picture p57: page 1]
ФНЧ 1; ВДК; ОСН; ФНЧ 2; Т. контр.; Усилитель низкой; Схема электрическая структурная; Формат A3; ФНЧ; Фильтр низких частот; Инв. №; л. Под; бл. Под; Перв. п

Сокр. | Наименование
В | Выпрямитель
ВДК | Входной дифференциальный каскад
Д | Динамик
ДВК | Двухтактный выходной каскад
ИТ | Источник тока
ОСН | Обратная связь по напряжению
ОЭ | Общий эмиттер

Изм. | Лист | № докум. | Подп. | Дата
Разраб. | | Бакулевский М. В.
Пров. | | Семенцов С. Г.

ЦС | Цепь смещения
ЦЦ | Цепь Цобеля

Нач.отд. | МГТУ им. Н.Э. Баумана Кафедра ИУ4 Группа ИУ4-52Б
Н. контр.
Утв.
