bakul14/siemens_kur/src/altium/pd1_separated/Э3.pdf

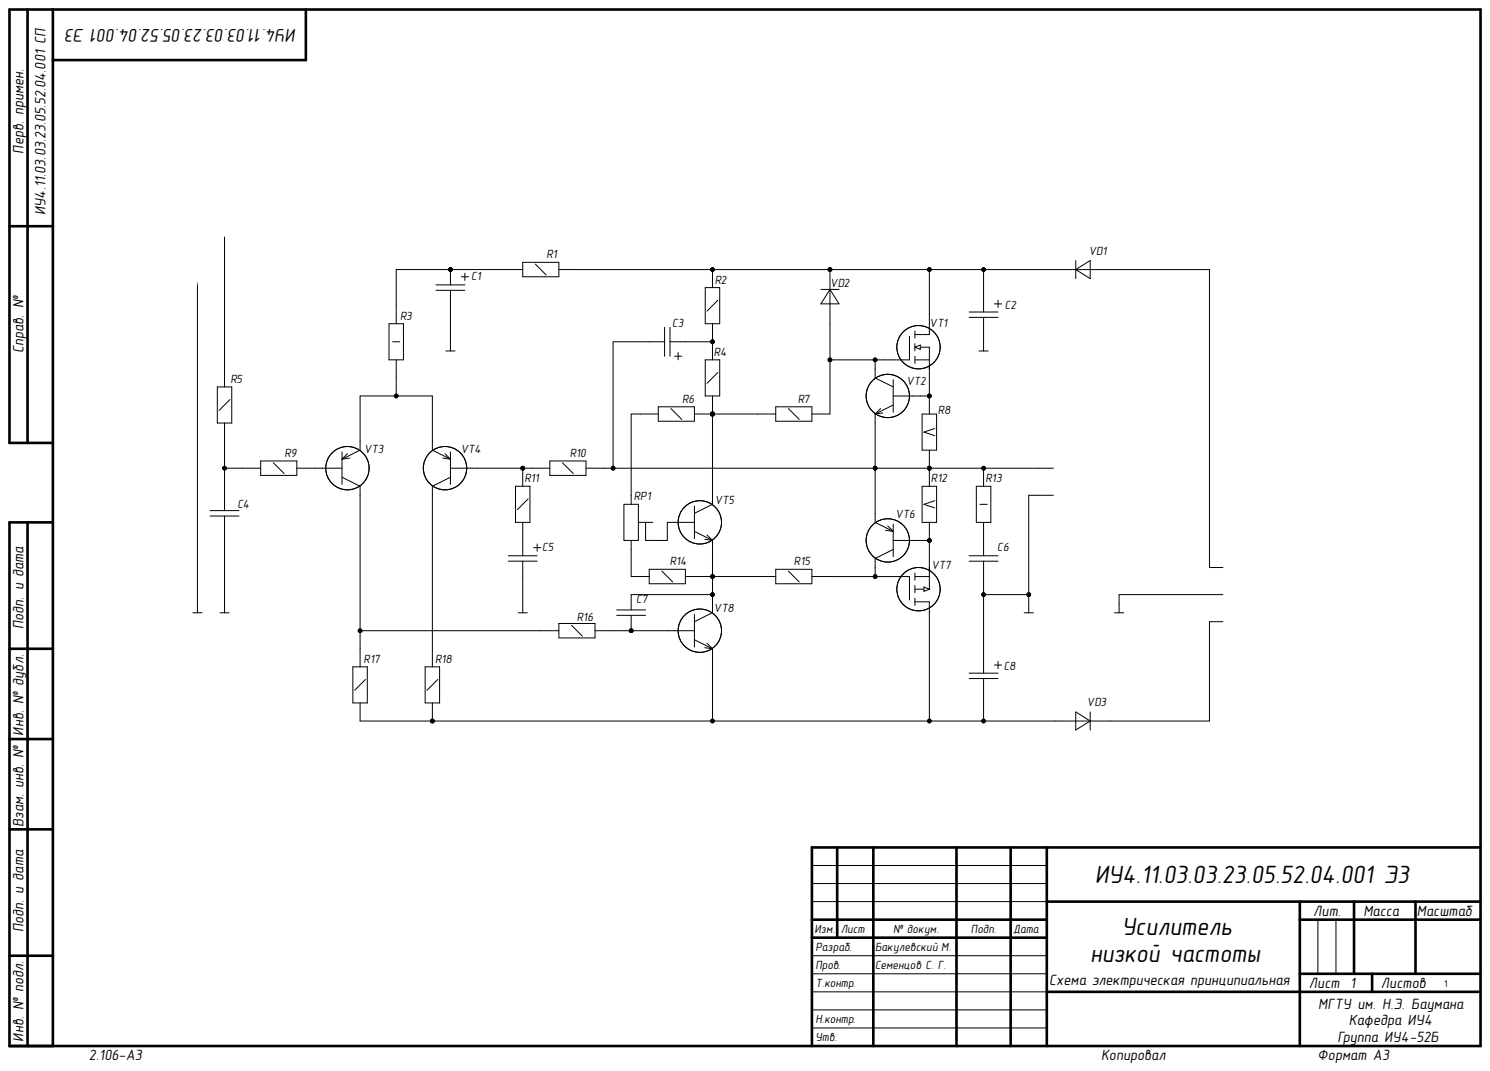
[picture p58: page 1]

Инв. № подл. Инв. № дубл. Подп. и дата Взам. инв. № Подп. и дата Перв. примен. Справ. №

Кон т . | Цеп ь

Общий

Вхо д

12 | Выхо д

123 | Общий

Усилитель низкой частоты Схем а электрическая принципиальная | Лит . | Масса | Масштаб

Изм . | Лис т | № докум . | Под п . | Дат а
Разраб. | | Бакулевский М .
Про в. | | Семенцов С . Г .
Т . кон т р . | | | | | Лист 1 | Листов 1

МГТ У им. Н . Э. Баумана Кафедра И У 4 Группа И У 4-52 Б

Н . кон т р .
Ут в.
