bakul14/siemens_kur/src/altium/amplifier60w/amplifier60w.pdf

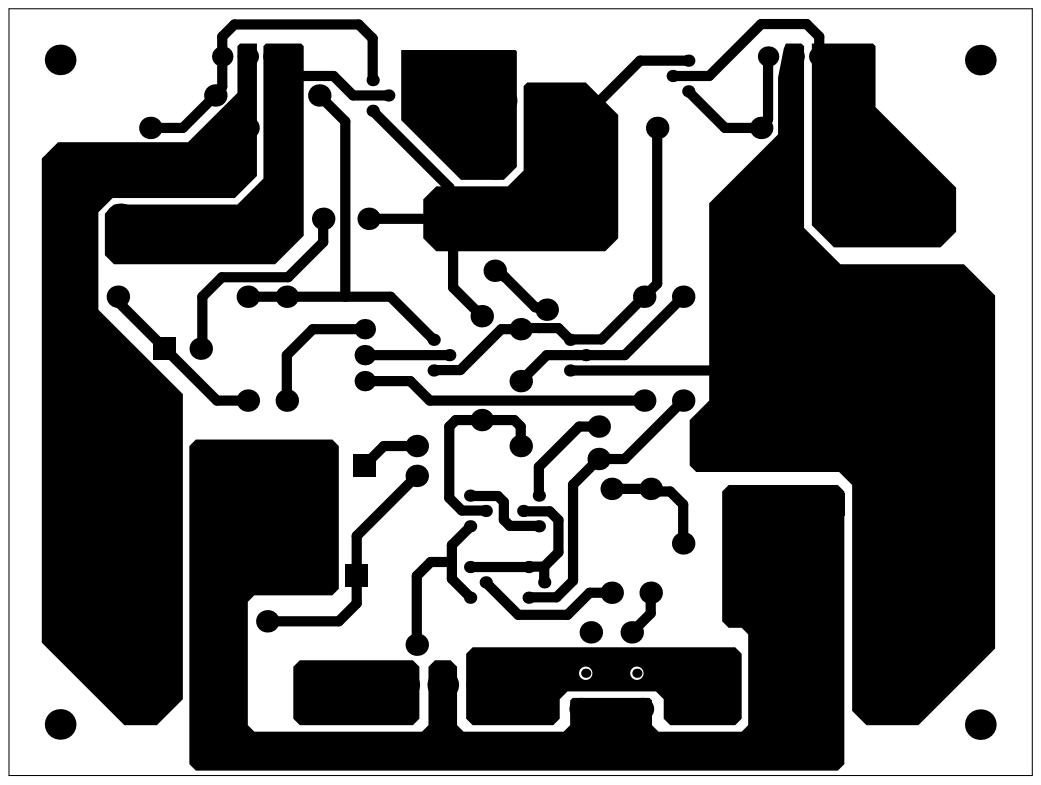
[picture p59: page 1]
