bakul14/siemens_kur/src/altium/amplifier60w/Project Outputs for amplifier60w/Job2.PDF

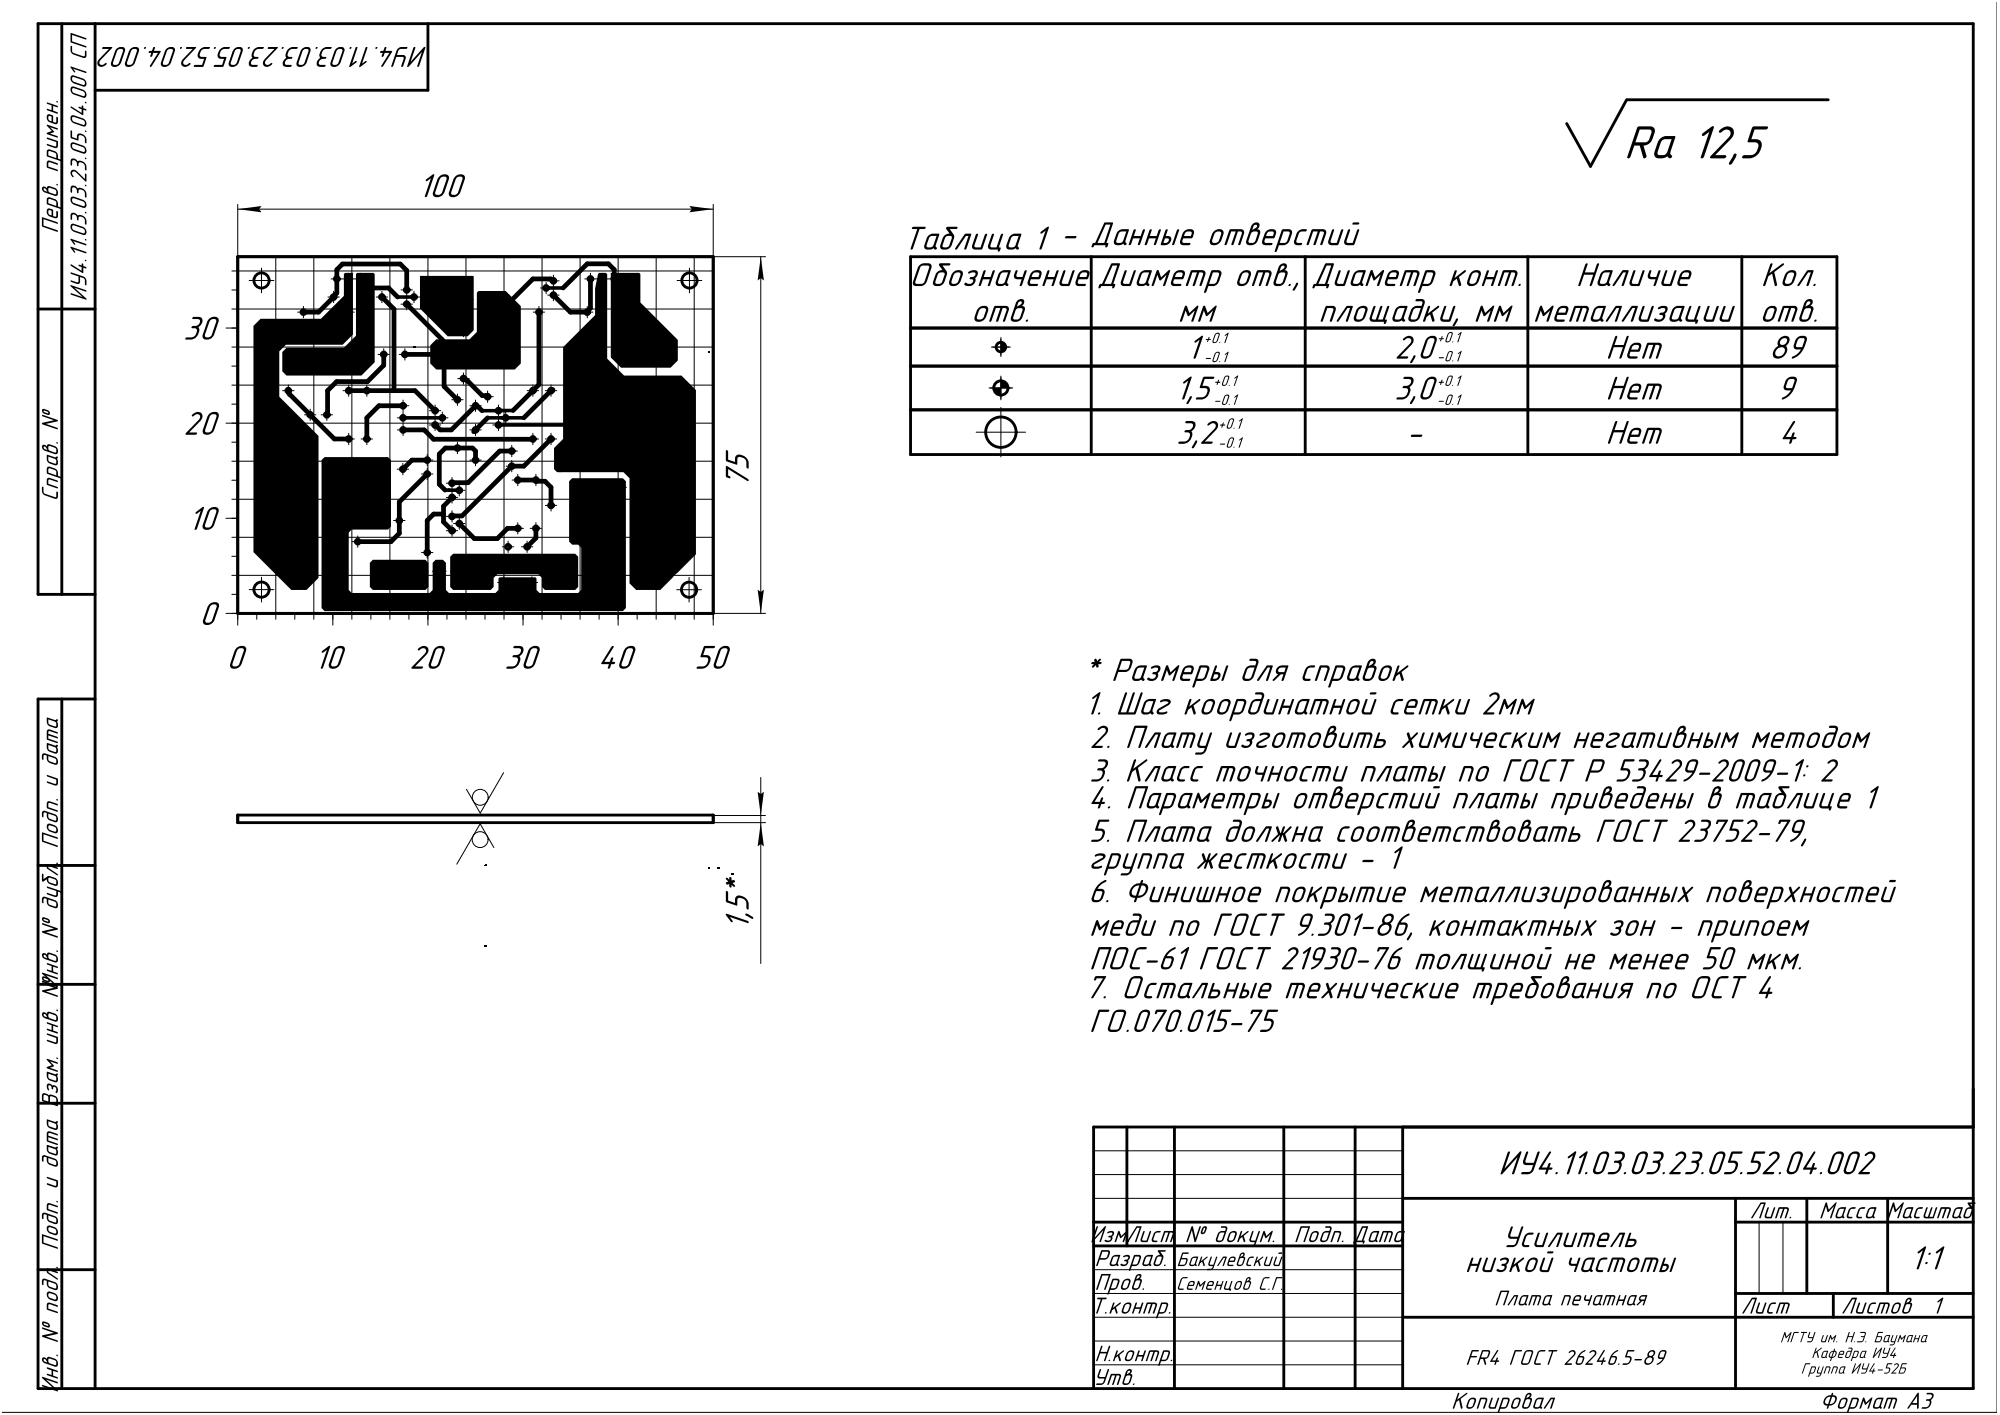
[picture p60: page 1]
