bakul14/siemens_kur/src/altium/amplifier60w/Документация/PCB1.PcbDoc.pdf

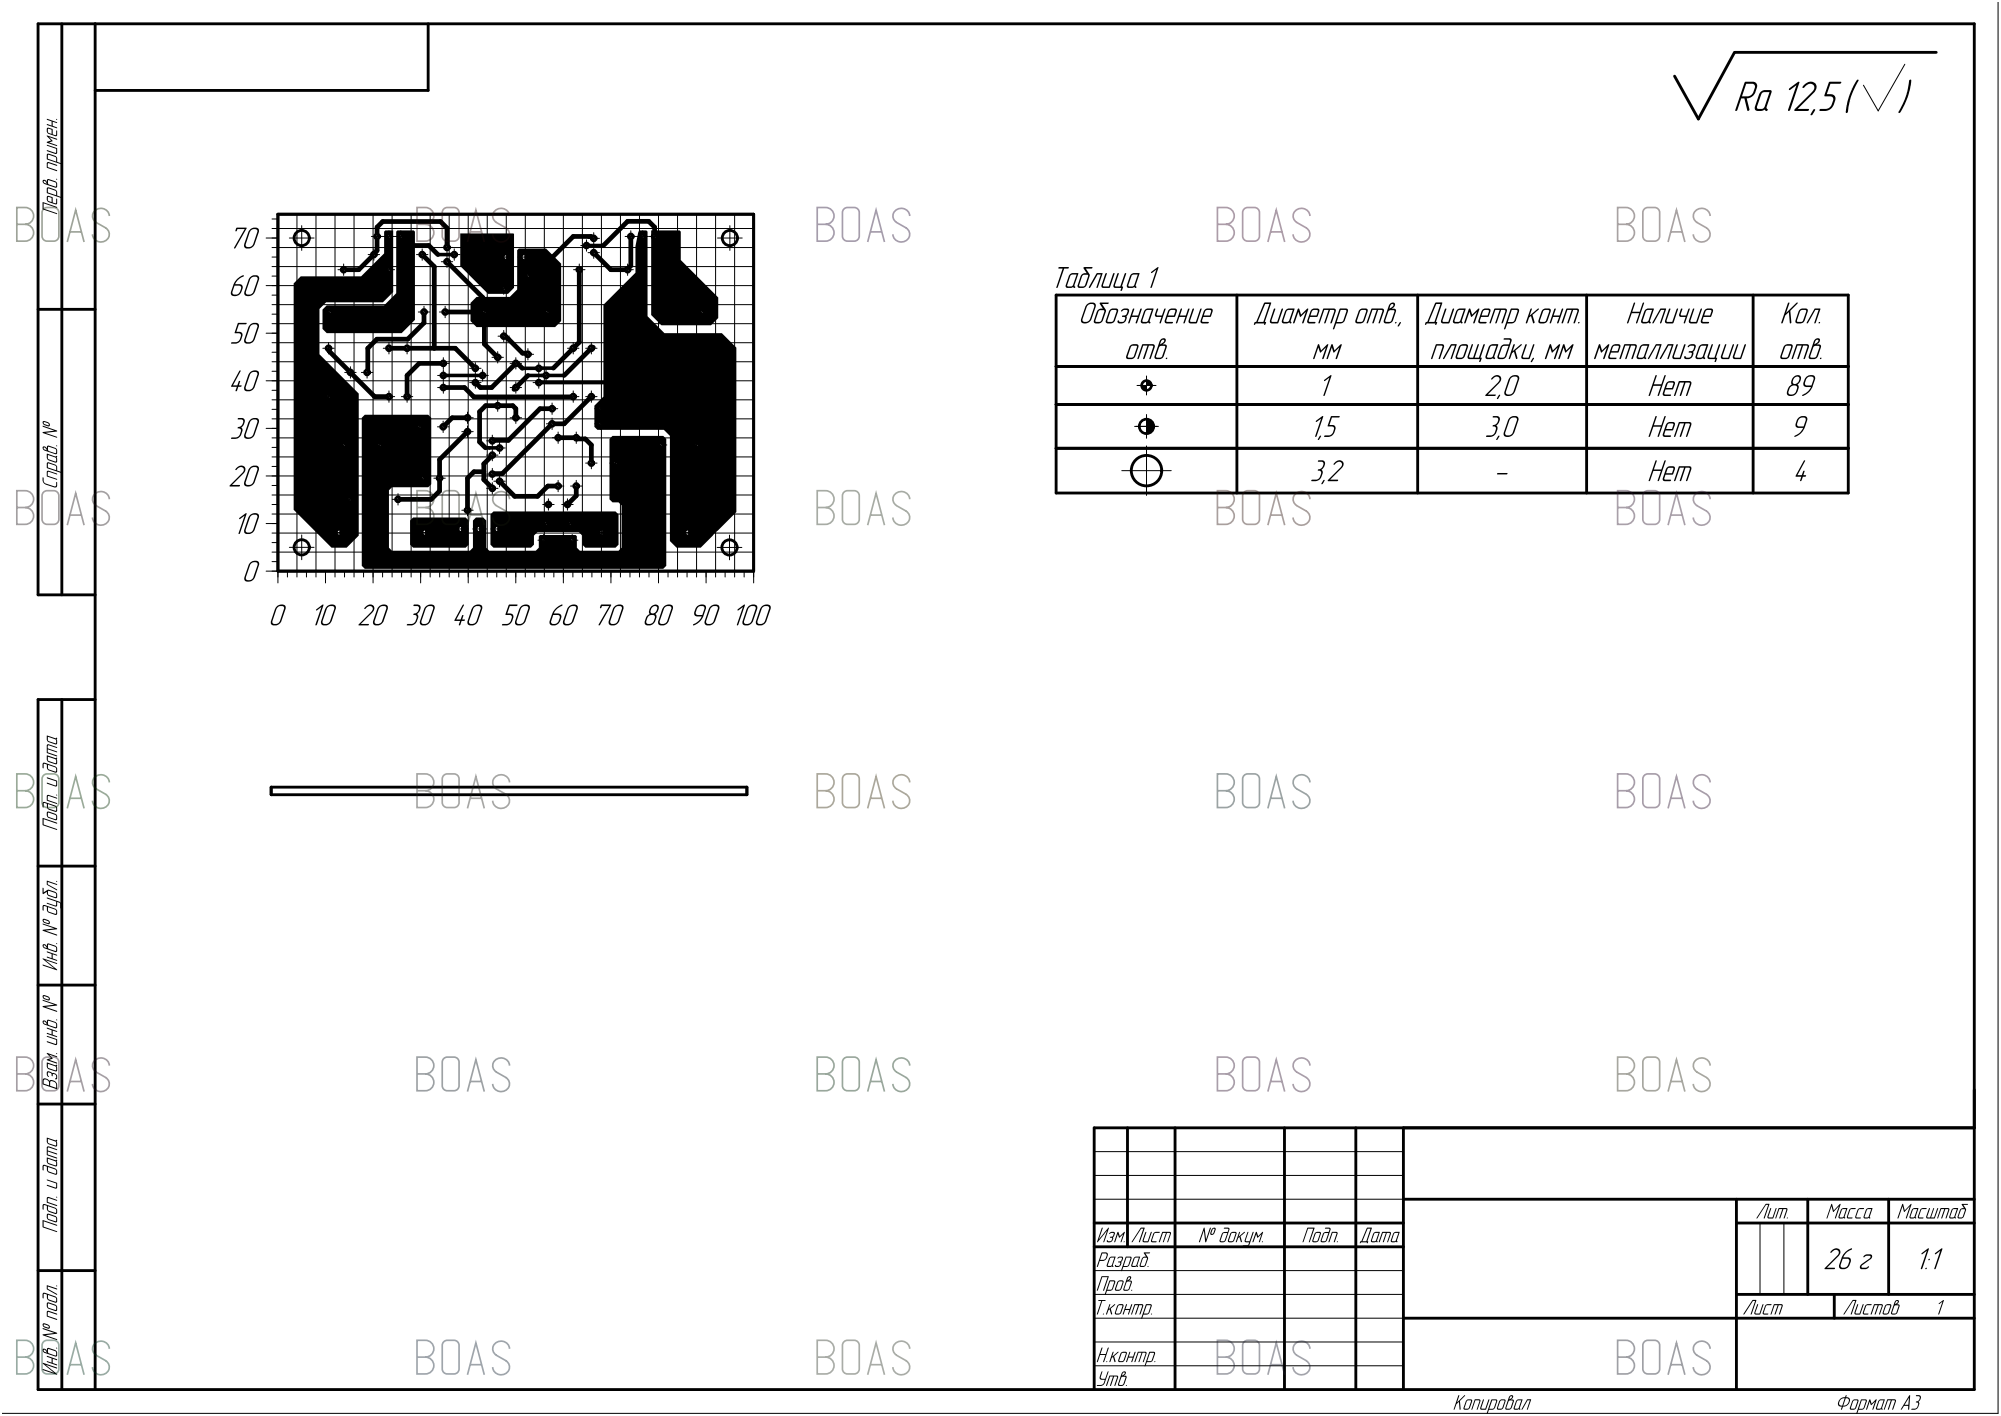
[picture p61: page 1]
COZBOAS224493425; COZBOAS230095275; COZBOAS874097559
