bakul14/siemens_kur/src/altium/amplifier60w/Документация/ИУ4.11.03.03.23.05.52.04.002.pdf

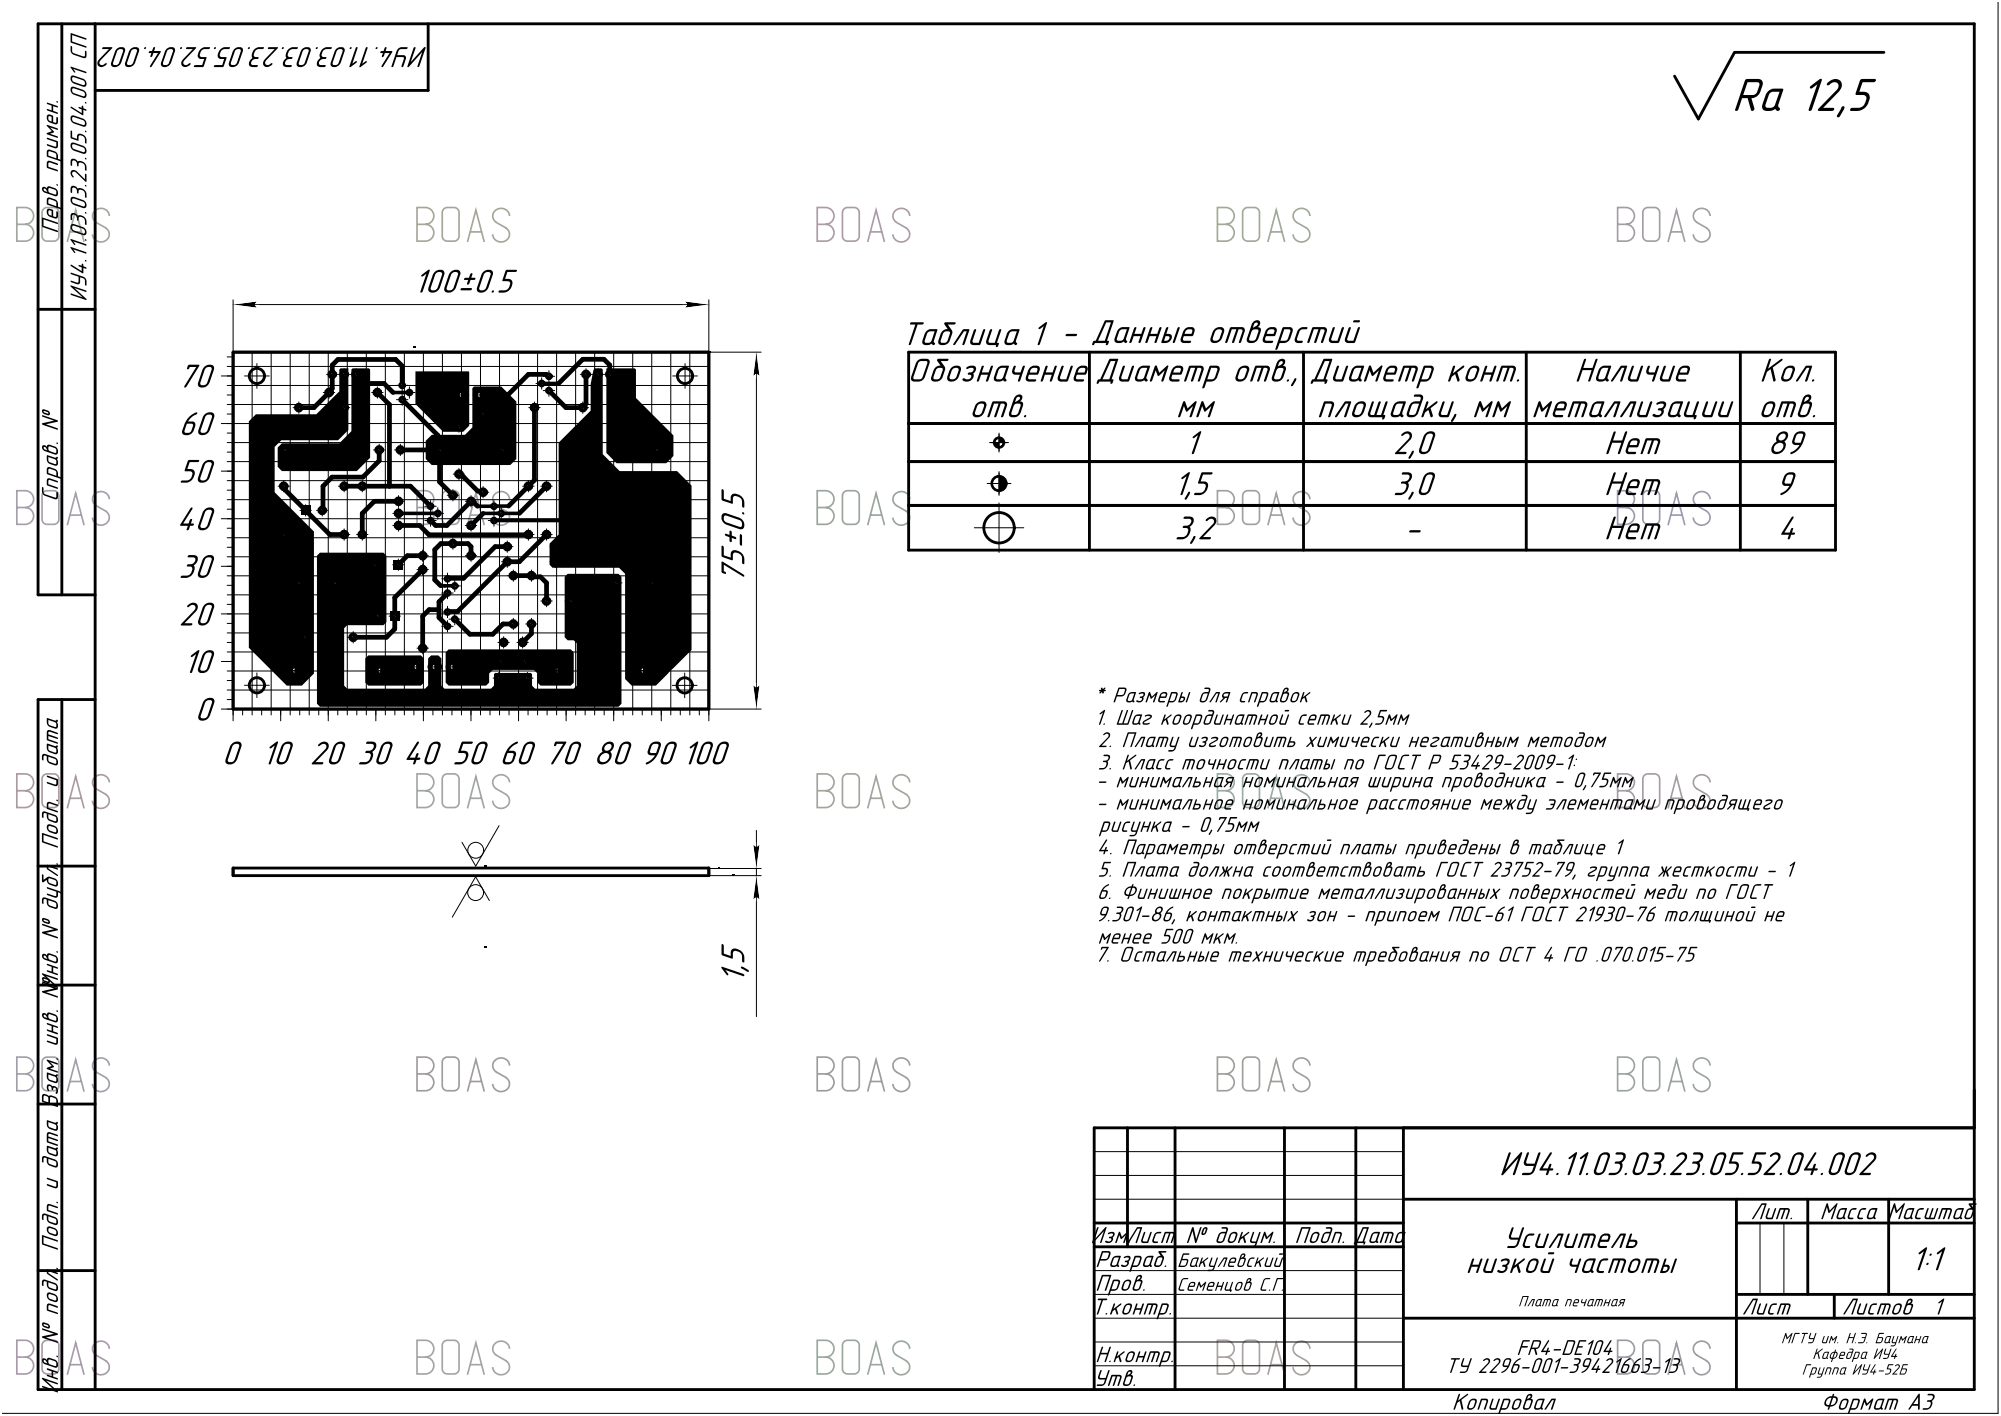
[picture p62: page 1]
COZBOAS192992755; COZBOAS192994133; COZBOAS751997086
