bakul14/siemens_kur/(list of files, drawings)

Other design files:
src/altium/amplifier60w/amplifier60w.PrjPcb
src/altium/amplifier60w/PCB1.PcbDoc
src/altium/amplifier60w/PcbLib1.PcbLib
src/altium/amplifier60w/Schlib1.SchLib
src/altium/amplifier60w/Sheet1.SchDoc
src/altium/pd1_separated/Sheet1.SchDoc
