bakul14/siemens_kur/(commit log)

2023-11-23 (+) added schematic
    [PCB1.PcbDoc, PcbLib1.PcbLib, Schlib1.SchLib, Sheet1.SchDoc, amplifier60w.PrjPcb]
2023-11-24 (+) added pcb
    [PCB1.PcbDoc, PcbLib1.PcbLib, Schlib1.SchLib, Sheet1.SchDoc]
2023-11-24 (~) ready pcb
    [PCB1.PcbDoc, amplifier60w.PrjPcb]
2023-11-28 (+) added the simulation
    [PCB1.PcbDoc, amplifier60w.PrjPcb, working_fet1.sch]
2023-11-30 added e1 and e3, changed repo structure
    [PCB1.PcbDoc, PcbLib1.PcbLib, Schlib1.SchLib, Sheet1.SchDoc, Sheet1.dwg, amplifier60w.PrjPcb, e1.0003.dwg, e1.dwg]
2023-11-30 removed <GND> text on the common power ports
    [Sheet1.SchDoc, amplifier60w.PrjPcb]
2023-11-30 source folder was renamed to src
    [PCB1.PcbDoc, PcbLib1.PcbLib, Schlib1.SchLib, Sheet1.SchDoc, Sheet1.dwg, amplifier60w.PrjPcb, e1.0003.dwg, e1.dwg]
2023-11-30 mosfet was changed to bipolar in the voltage amplifier
    [Sheet1.SchDoc]
2023-11-30 (-) current mirror was deleted from pcb
    [PCB1.PcbDoc, amplifier60w.PrjPcb]
2023-11-30 (+) added pcd pdf file
    [PCB1.PcbDoc, amplifier60w.PrjPcb]
2023-11-30 (+) added designator for the zobel capacitor in E3
    [15EDGRC-3.81-02P-14-00A(H)_RGB5220458.ipt, 15EDGRC-3.81-03P-14-00A(H)_RGB5220458.ipt, Audio_Jack_3.5_mm__Cliff_FC68125.iam, Board.iam, C1.iam, C2.iam, C3.iam, C4.iam]
2023-12-01 (+) added assembling (SB)
    [15EDGRC-3.81-02P-14-00A(H)_RGB5220458.0001.ipt, 15EDGRC-3.81-02P-14-00A(H)_RGB5220458.ipt, 15EDGRC-3.81-03P-14-00A(H)_RGB5220458.0001.ipt, 15EDGRC-3.81-03P-14-00A(H)_RGB5220458.ipt, Audio_Jack_3.5_mm__Cliff_FC68125.0001.iam, Audio_Jack_3.5_mm__Cliff_FC68125.iam, Board.0001.iam, Board.iam]
